BIKEL-PL/MPe_V6_open_source/README.md

# MPeV6 - DIY ebike computer

EN: More info https://bikel.pl/en/mpe-computer-for-e-bike/

PL: Więcej informacji: https://bikel.pl/komputer-mpe-do-e-bike/
