BIKEL-PL/MPe_V6_open_source/firmware/source/MPe-firmware/README.md

# MPe-firmware

Firmware of MPe main board - Atmega328P / Arduino
