BIKEL-PL/MPe_V6_open_source/docs/photos/20200317_091047.jpg

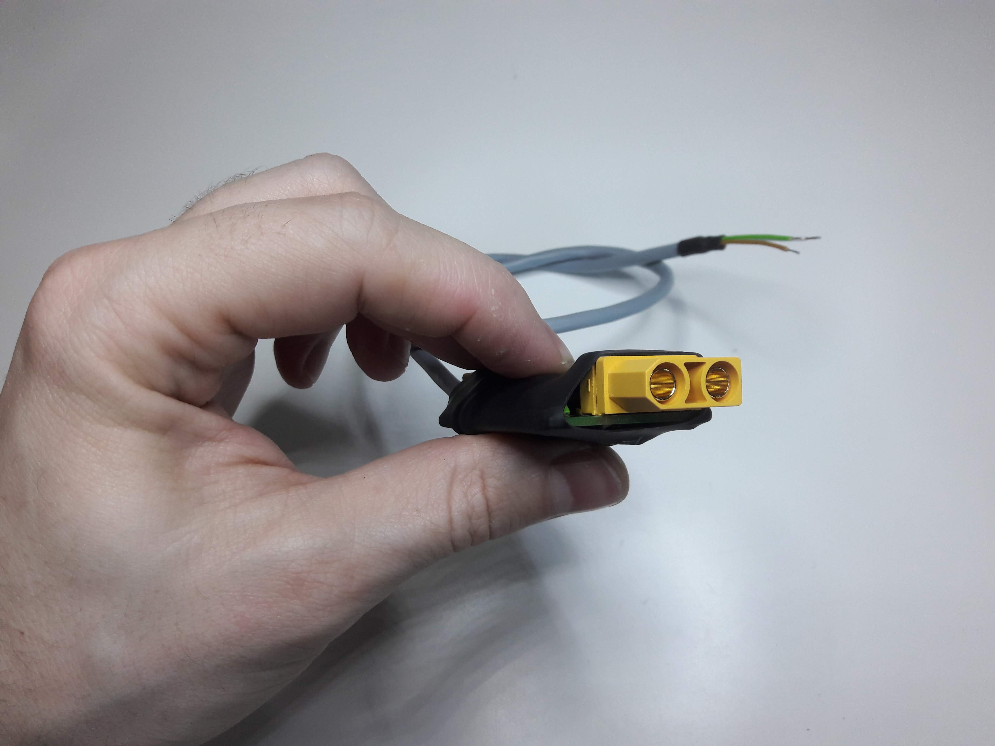
docs/photos/20200317_091047.jpg
