BIKEL-PL/MPe_V6_open_source/docs/photos/20200317_093044.jpg

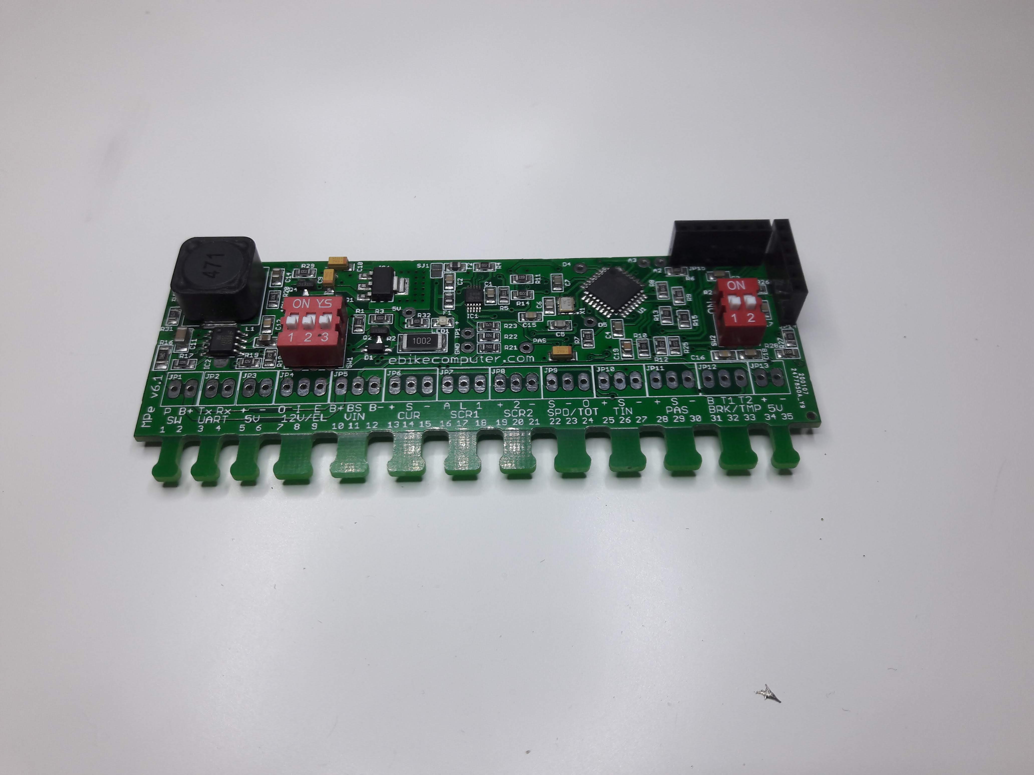
docs/photos/20200317_093044.jpg
