BIKEL-PL/MPe_V6_open_source/docs/photos/20211012_111339.jpg

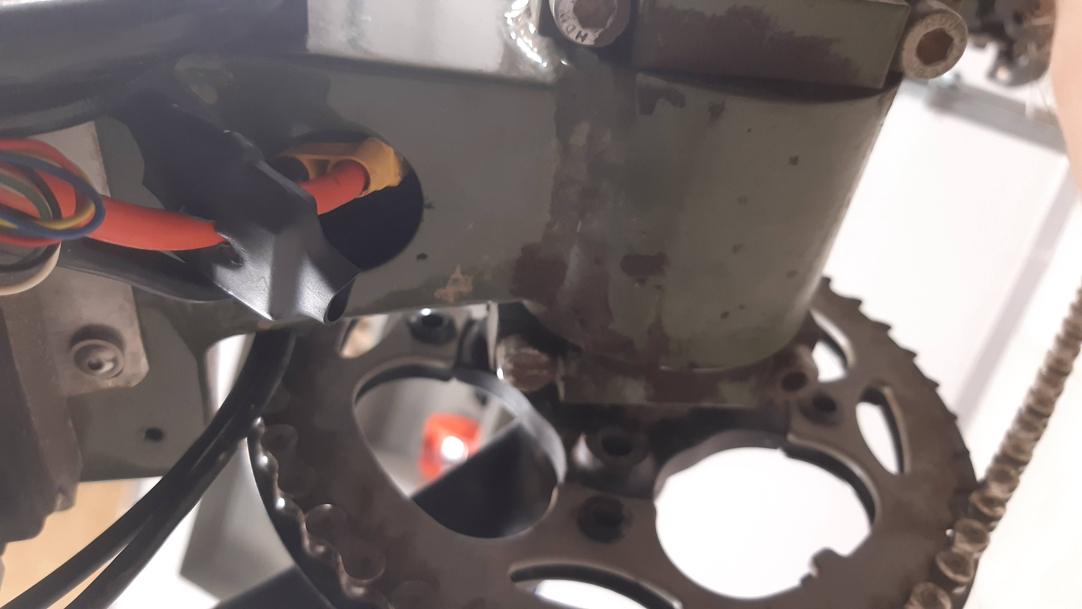
docs/photos/20211012_111339.jpg
