BIKEL-PL/MPe_V6_open_source/docs/photos/20211012_130520.jpg

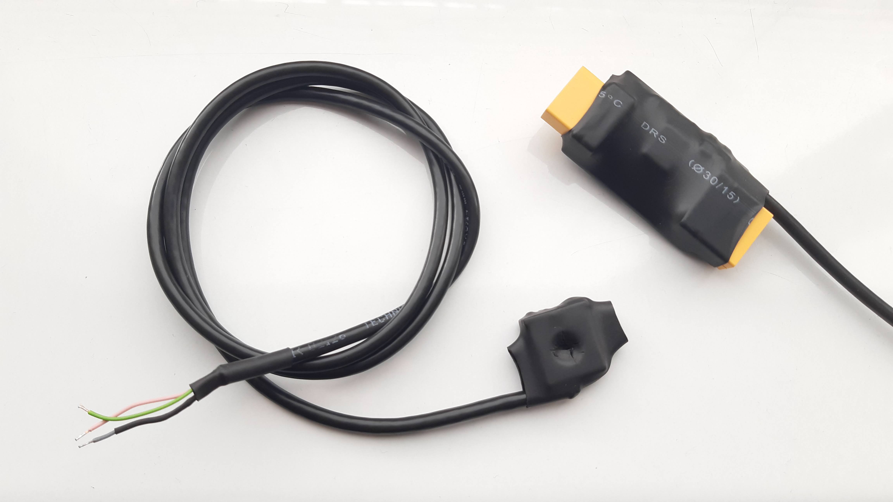
docs/photos/20211012_130520.jpg
