BIKEL-PL/MPe_V6_open_source/hardware/mainboard/gerber/BOM.xls

Comment | Designator | Footprint | JLCPCB Part #
2 | R20 | 0805 | C17606
2 | R32 | 0805 | C17606
1.5k | R19 | 0603 | C22843
100K | R10 | 0603 | C25803
100K | R15 | 0603 | C25803
100k | R16 | 0603 | C25803
100nF | C1 | 0603 | C14663
100nF | C17 | 0603 | C14663
100nF | C18 | 0603 | C14663
100nF | C2 | 0603 | C14663
100nF | C20 | 0603 | C14663
100nF | C3 | 0603 | C14663
100nF | C4 | 0603 | C14663
100nF | C7 | 0603 | C14663
10K | R12 | 0603 | C25804
10K | R13 | 0603 | C25804
10k | R25 | 0603 | C25804
10K | R29 | 0603 | C25804
10k | R4 | 0603 | C25804
10K | R44 | 0603 | C25804
10K | R45 | 0603 | C25804
10K | R46 | 0603 | C25804
10k | R5 | 0603 | C25804
10k | R6 | 0603 | C25804
10nF | C12 | 0805 | C1710
10nF | C15 | 0603 | C57112
10nF | C16 | 0603 | C57112
10uF | C10 | CASE-A_3216 | C7171
10uF | C8 | CASE-A_3216 | C7171
10uF | C9 | CASE-A_3216 | C7171
12pF | C5 | 0603 | C38523
12pF | C6 | 0603 | C38523
13k | R18 | 0603 | C22797
1k | R1 | 0603 | C21190
1k | R2 | 0603 | C21190
1k | R26 | 0603 | C21190
1k | R27 | 0603 | C21190
1k | R30 | 0603 | C21190
1k | R31 | 0603 | C21190
1k | R33 | 0603 | C21190
1k | R34 | 0603 | C21190
1k | R35 | 0603 | C21190
1k | R36 | 0603 | C21190
1k | R37 | 0603 | C21190
1k | R38 | 0603 | C21190
1k | R39 | 0603 | C21190
1k | R40 | 0603 | C21190
1k | R41 | 0603 | C21190
1k | R42 | 0603 | C21190
1k | R43 | 0603 | C21190
1k | R7 | 0603 | C21190
1nF | C19 | 0603 | C1588
1uF | C11 | 1206 | C13832
1uF | C13 | 0603 | C15849
200mA 60V | FU2 | 1812 | C70108
22k | R24 | 0603 | C31850
22uF | C14 | 0805 | C45783
2k2 | R11 | 0603 | C4190
2k2 | R14 | 0603 | C4190
2k2 | R28 | 0603 | C4190
2k2 | R8 | 0603 | C4190
2k2 | R9 | 0603 | C4190
470uH SLF12555T-102MR34-PF | L1 | SMD-PIND-12.5x12.5x8_2.9x5.4 | C169382
4k7 | R23 | 0805 | C17673
4k7 | R3 | 0603 | C23162
4u7 | C21 | 0603 | C19666
560k | R17 | 0603 | C23203
75k | R21 | 0805 | C17819
75k | R22 | 0805 | C17819
ADS1115 | IC1 | MSOP-10 | C37593
AMS1117-5.0 | IC3 | SOT-223 | C6187
ATMEGA328P_TQFP | U1 | TQFP-32_7x7x08P | C14877
Diode | D1 | SOD-123 | C64898
Diode | D5 | SOD-123 | C64898
ferrit805 | F1 | 0805 | C1017
green 5V | LED1 | 0805 | C2297
LM5017MR/NOPB | IC2 | SOIC-8_EP_150mil | C34355
red 12V | LED2 | 0805 | C84256
Schottky SS14 | D3 | DO-214AC | C2480
TVS 13Vrmw | TS2 | DO-214AA | C283991
TVS 90Vrmw | TS1 | DO-214AA | C173538
TVS 90Vrmw | TS3 | DO-214AA | C173538
X322516MLB4SI | X1 | SMD-3225_4P | C13738
Zener 5.6V | D2 | LL-34 | C8062
