BIKEL-PL/MPe_V6_open_source/hardware/current_sensor_boards/PowerPCB_180/gerber/BOM.xls

Comment | Designator | Footprint | LCSC Part #
1k | R1 | 0805 | C17513
100nF | C1 | 0805 | C49678
100nF | C2 | 0805 | C49678
