BIKEL-PL/MPe_V6_open_source/hardware/misc/APT_displays_flash_adapter/gerber/BOM_PRG_APT.xls

Comment | Designator | Footprint | LCSC Part #
22uH | L1 | SMD-PIND-12.5x12.5x6_2.9x5.4 | C169385
diode | D1 | SMA,DO-214AC | C8678
dc/dc | IC1 | SOT-23-6L | C84817
22uf | C1 | 0805 | C45783
22uf | C2 | 0805 | C45783
2k2 | R2 | 0805 | C17520
100k | R1 | 0805 | C17407
1000uF 6.3V | C3 | SMD-ECAP-8x10 | C134755
220uF 50V | C4 | SMD_10x10.5mm | C88818
USB MINI | CN1 | MINI_USB_SMD | C91144
10R0 | R4 | 1206 | C17903
