BIKEL-PL/MPe_V6_open_source/hardware/display_minioled/front/front.DXF

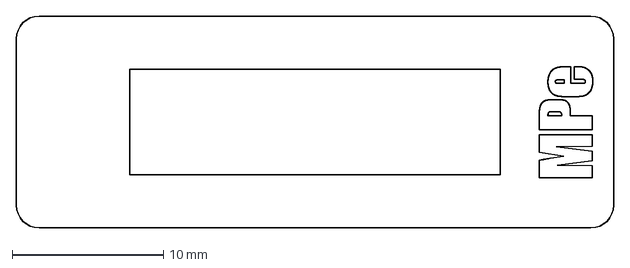
[picture p22: CAD file, 2025-05-25]
hardware/display_minioled/front/front.DXF
39.5 x 14.0 mm
