BIKEL-PL/MPe_V6_open_source/hardware/display_minioled/holder.STL

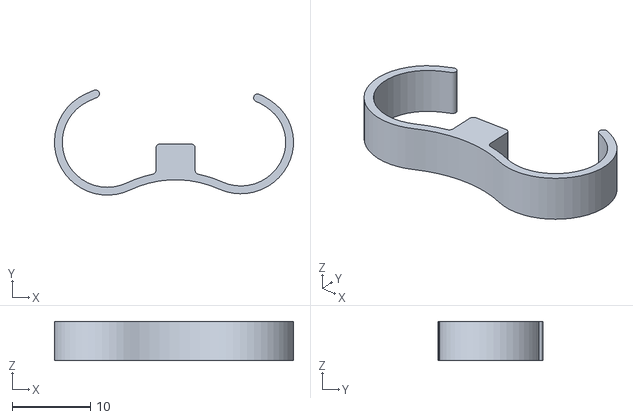
[picture p23: CAD file, 2025-05-25]
hardware/display_minioled/holder.STL
30.5 x 13.4 x 5.00
