BIKEL-PL/MPe_V6_open_source/hardware/mainboard_housing/bottom/MPeV6-bottom.STL

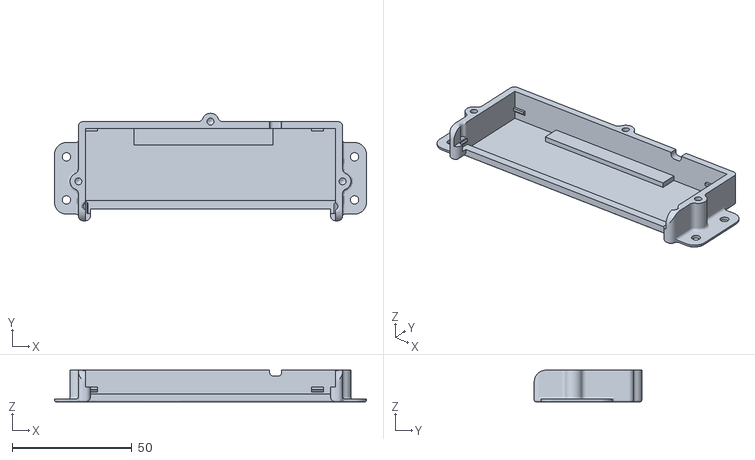
[picture p24: CAD file, 2025-05-25]
hardware/mainboard_housing/bottom/MPeV6-bottom.STL
130.5 x 45.0 x 13.3
