BIKEL-PL/MPe_V6_open_source/hardware/misc/bluetooth_adapter/stl/free-space-filler-small.STL

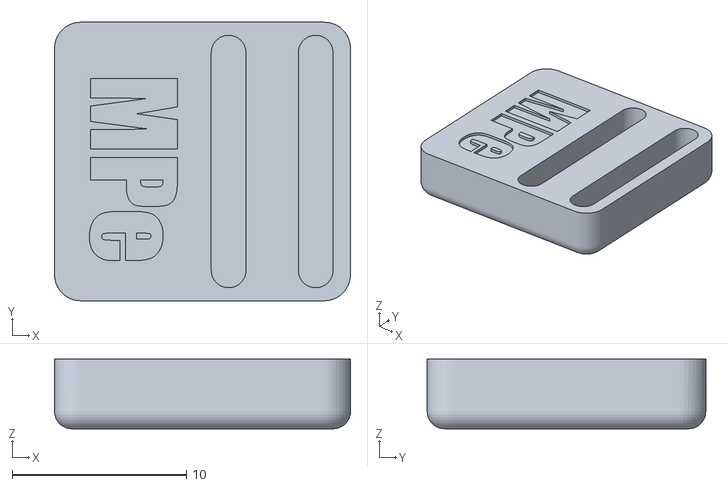
[picture p25: CAD file, 2025-05-25]
hardware/misc/bluetooth_adapter/stl/free-space-filler-small.STL
17.0 x 16.0 x 4.00
