BIKEL-PL/MPe_V6_open_source/hardware/display_minioled/MPe-minioled.STL

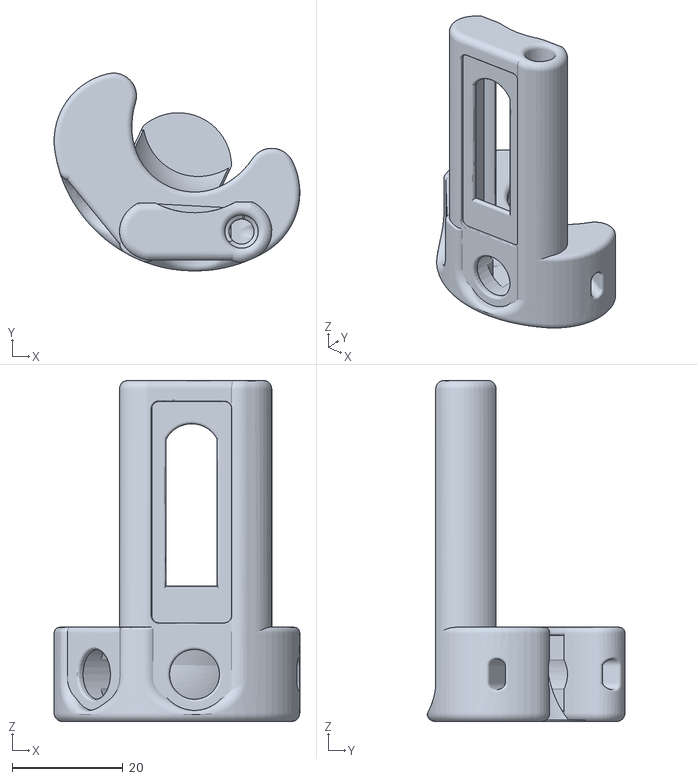
[picture p26: CAD file, 2025-05-25]
hardware/display_minioled/MPe-minioled.STL
44.3 x 35.7 x 61.5
