BIKEL-PL/MPe_V6_open_source/hardware/misc/bluetooth_adapter/stl/free-space-filler-large.STL

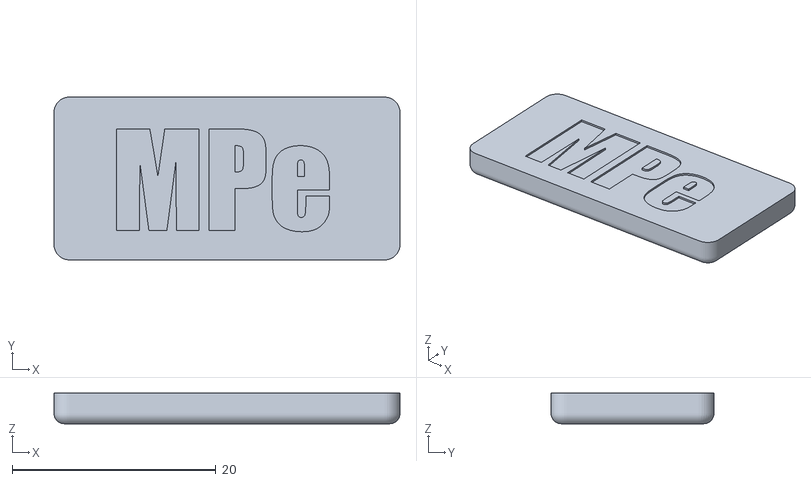
[picture p27: CAD file, 2025-05-25]
hardware/misc/bluetooth_adapter/stl/free-space-filler-large.STL
34.0 x 16.0 x 3.00
