BIKEL-PL/MPe_V6_open_source/hardware/display_minioled/assembly-video.txt

https://youtu.be/sY0HN42a0uE
https://youtu.be/gLpKM8VGKTg
