BIKEL-PL/MPe_V6_open_source/docs/schematics/S1.02_MPeV6.pdf

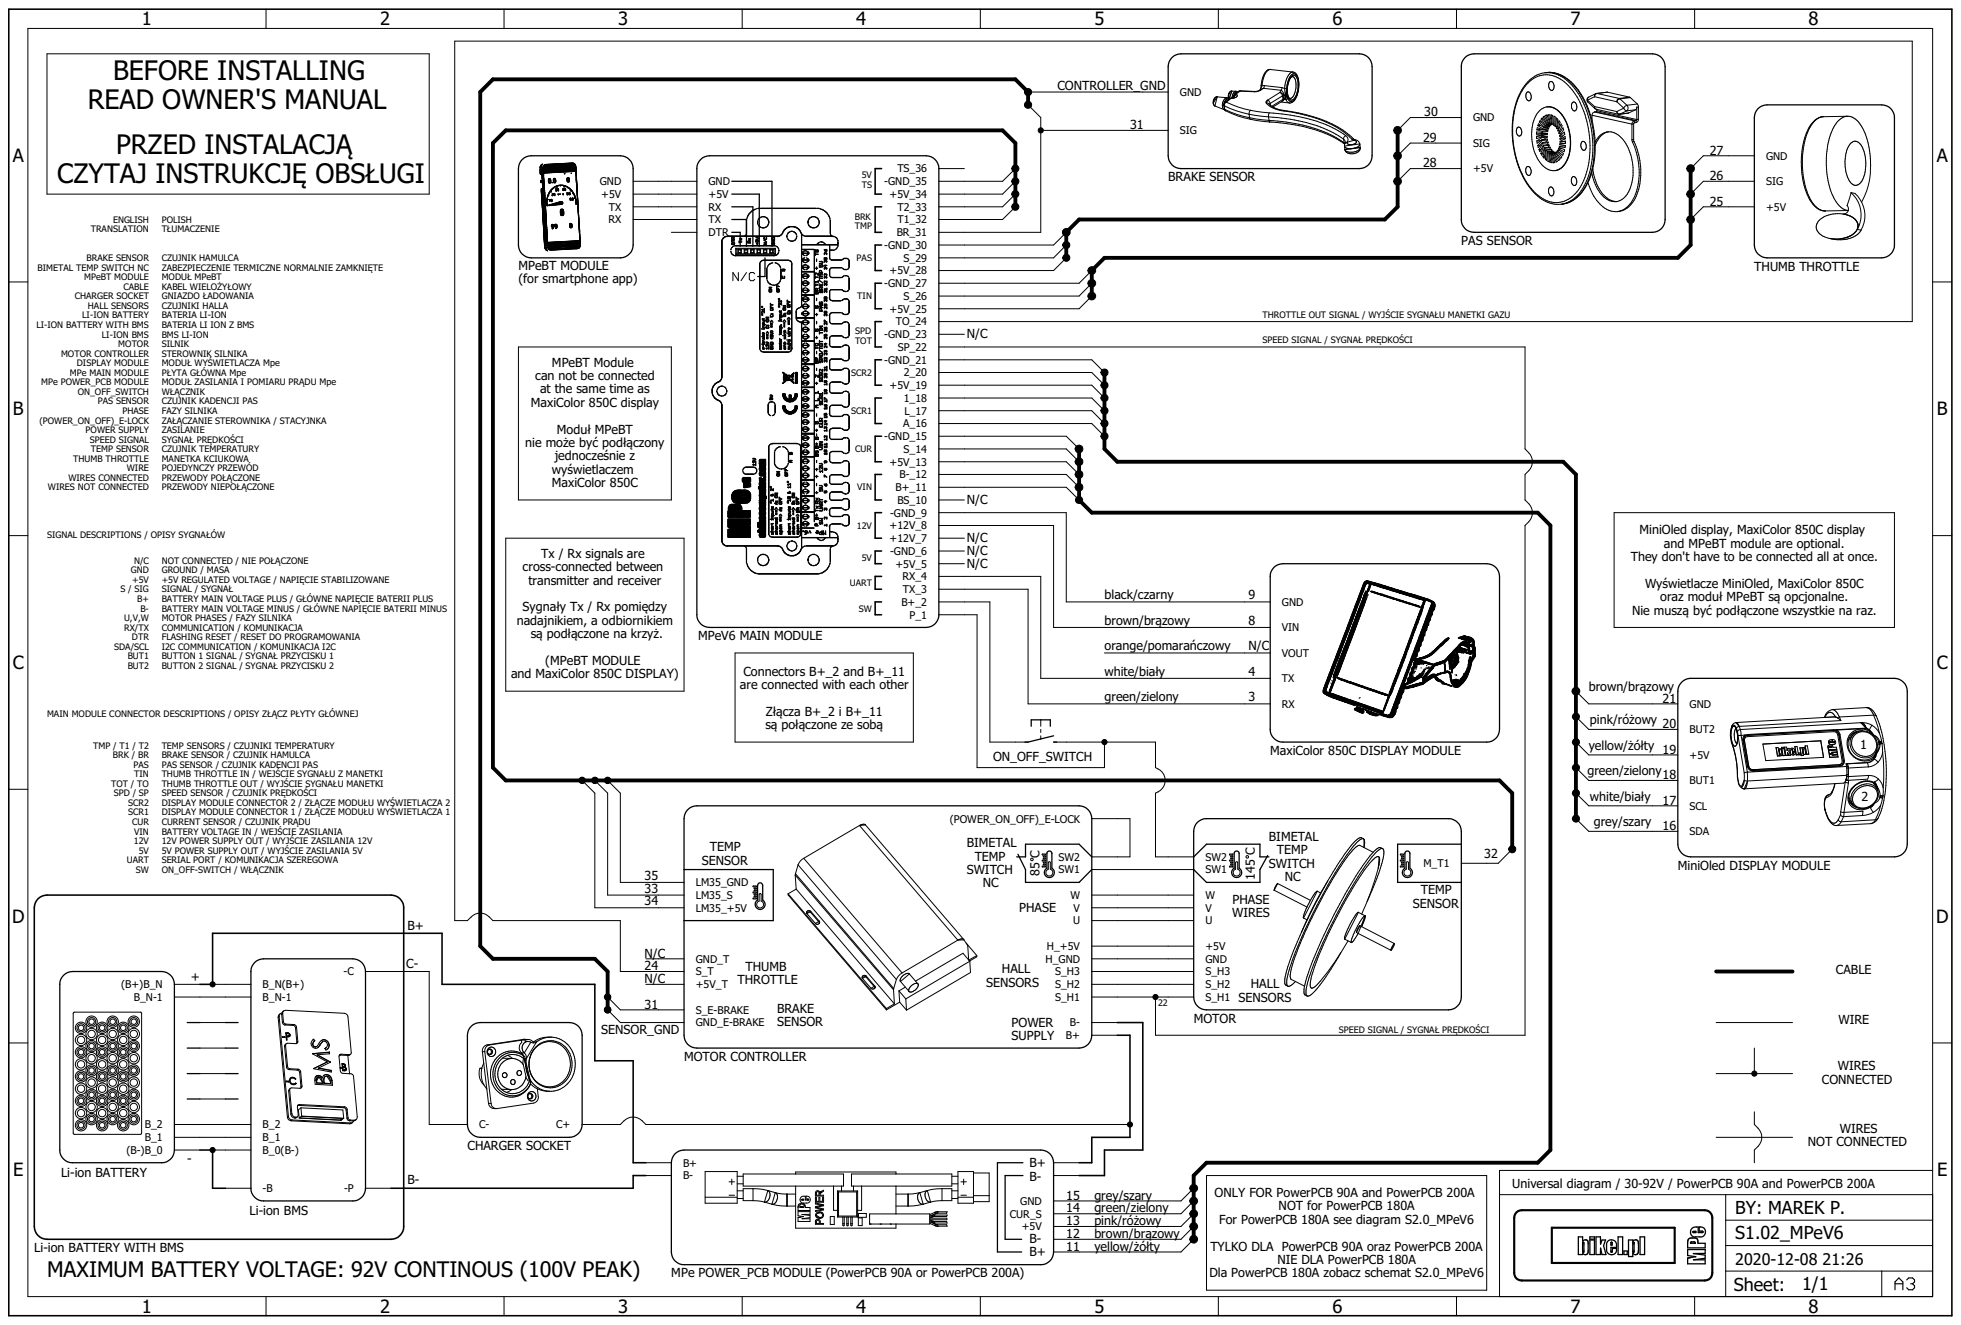
[picture p28: page 1]

BRAKE SENSOR MPeBT MODULE

BIMETAL TEMP SWITCH NC MPeBT MODULE CABLE CHARGER SOCKET HALL SENSORS

ZABEZPIECZENIE TERMICZNE NORMALNIE ZAMKNIĘTE MODUŁ MPeBT KABEL WIELOŻYŁOWY GNIAZDO ŁADOWANIA CZUJNIKI HALLA

(for smartphone app)

LI-ION BATTERY WITH BMS
LI-ION BMS MOTOR MOTOR CONTROLLER DISPLAY MODULE MPe MAIN MODULE MPe POWER_PCB MODULE ON_OFF_SWITCH

BATERIA LI-ION
BATERIA LI ION Z BMS BMS LI-ION

THROTTLE OUT SIGNAL / WYJŚCIE SYGNAŁU MANETKI GAZU

SILNIK
STEROWNIK SILNIKA MODUŁ WYŚWIETLACZA Mpe PŁYTA GŁÓWNA Mpe MODUŁ ZASILANIA I POMIARU PRĄDU Mpe WŁĄCZNIK CZUJNIK KADENCJI PAS

SPEED SIGNAL / SYGNAŁ PRĘDKOŚCI

MPeBT Module
can not be connected
at the same time as MaxiColor 850C display Moduł MPeBT

FAZY SILNIKA
ZAŁĄCZANIE STEROWNIKA / STACYJNKA
ZASILANIE
SYGNAŁ PRĘDKOŚCI CZUJNIK TEMPERATURY MANETKA KCIUKOWA

POWER SUPPLY
SPEED SIGNAL TEMP SENSOR

nie może być podłączony
jednocześnie z wyświetlaczem

THUMB THROTTLE WIRE WIRES CONNECTED WIRES NOT CONNECTED

SIGNAL DESCRIPTIONS / OPISY SYGNAŁÓW

MiniOled display, MaxiColor 850C display and MPeBT module are optional. They don't have to be connected all at once. Wyświetlacze MiniOled, MaxiColor 850C

Tx / Rx signals are
cross-connected between
transmitter and receiver Sygnały Tx / Rx pomiędzy nadajnikiem, a odbiornikiem

NOT CONNECTED / NIE POŁĄCZONE GROUND / MASA +5V REGULATED VOLTAGE / NAPIĘCIE STABILIZOWANE

SIGNAL / SYGNAŁ BATTERY MAIN VOLTAGE PLUS / GŁÓWNE NAPIĘCIE BATERII PLUS BATTERY MAIN VOLTAGE MINUS / GŁÓWNE NAPIĘCIE BATERII MINUS MOTOR PHASES / FAZY SILNIKA COMMUNICATION / KOMUNIKACJA

black/czarny brown/brązowy white/biały green/zielony orange/pomarańczowy

oraz moduł MPeBT są opcjonalne. Nie muszą być podłączone wszystkie na raz.

są podłączone na krzyż. (MPeBT MODULE

FLASHING RESET / RESET DO PROGRAMOWANIA
I2C COMMUNICATION / KOMUNIKACJA I2C
BUTTON 1 SIGNAL / SYGNAŁ PRZYCISKU 1 BUTTON 2 SIGNAL / SYGNAŁ PRZYCISKU 2

are connected with each other Złącza B+_2 i B+_11

brown/brązowy pink/różowy

MAIN MODULE CONNECTOR DESCRIPTIONS / OPISY ZŁĄCZ PŁYTY GŁÓWNEJ

są połączone ze sobą

TEMP SENSORS / CZUJNIKI TEMPERATURY BRAKE SENSOR / CZUJNIK HAMULCA

yellow/żółty green/zielony white/biały grey/szary

PAS SENSOR / CZUJNIK KADENCJI PAS THUMB THROTTLE IN / WEJŚCIE SYGNAŁU Z MANETKI THUMB THROTTLE OUT / WYJŚCIE SYGNAŁU MANETKI SPEED SENSOR / CZUJNIK PRĘDKOŚCI DISPLAY MODULE CONNECTOR 2 / ZŁĄCZE MODUŁU WYŚWIETLACZA 2 DISPLAY MODULE CONNECTOR 1 / ZŁĄCZE MODUŁU WYŚWIETLACZA 1 CURRENT SENSOR / CZUJNIK PRĄDU

BATTERY VOLTAGE IN / WEJŚCIE ZASILANIA
12V POWER SUPPLY OUT / WYJŚCIE ZASILANIA 12V
5V POWER SUPPLY OUT / WYJŚCIE ZASILANIA 5V
SERIAL PORT / KOMUNIKACJA SZEREGOWA ON_OFF-SWITCH / WŁĄCZNIK

CABLE WIRE WIRES CONNECTED WIRES NOT CONNECTED

Universal diagram / 30-92V / PowerPCB 90A and PowerPCB 200A

ONLY FOR PowerPCB 90A and PowerPCB 200A NOT for PowerPCB 180A

Li-ion BATTERY WITH BMS

MPe POWER_PCB MODULE (PowerPCB 90A or PowerPCB 200A)
