BIKEL-PL/MPe_V6_open_source/docs/schematics/S10.01_MPeV6.pdf

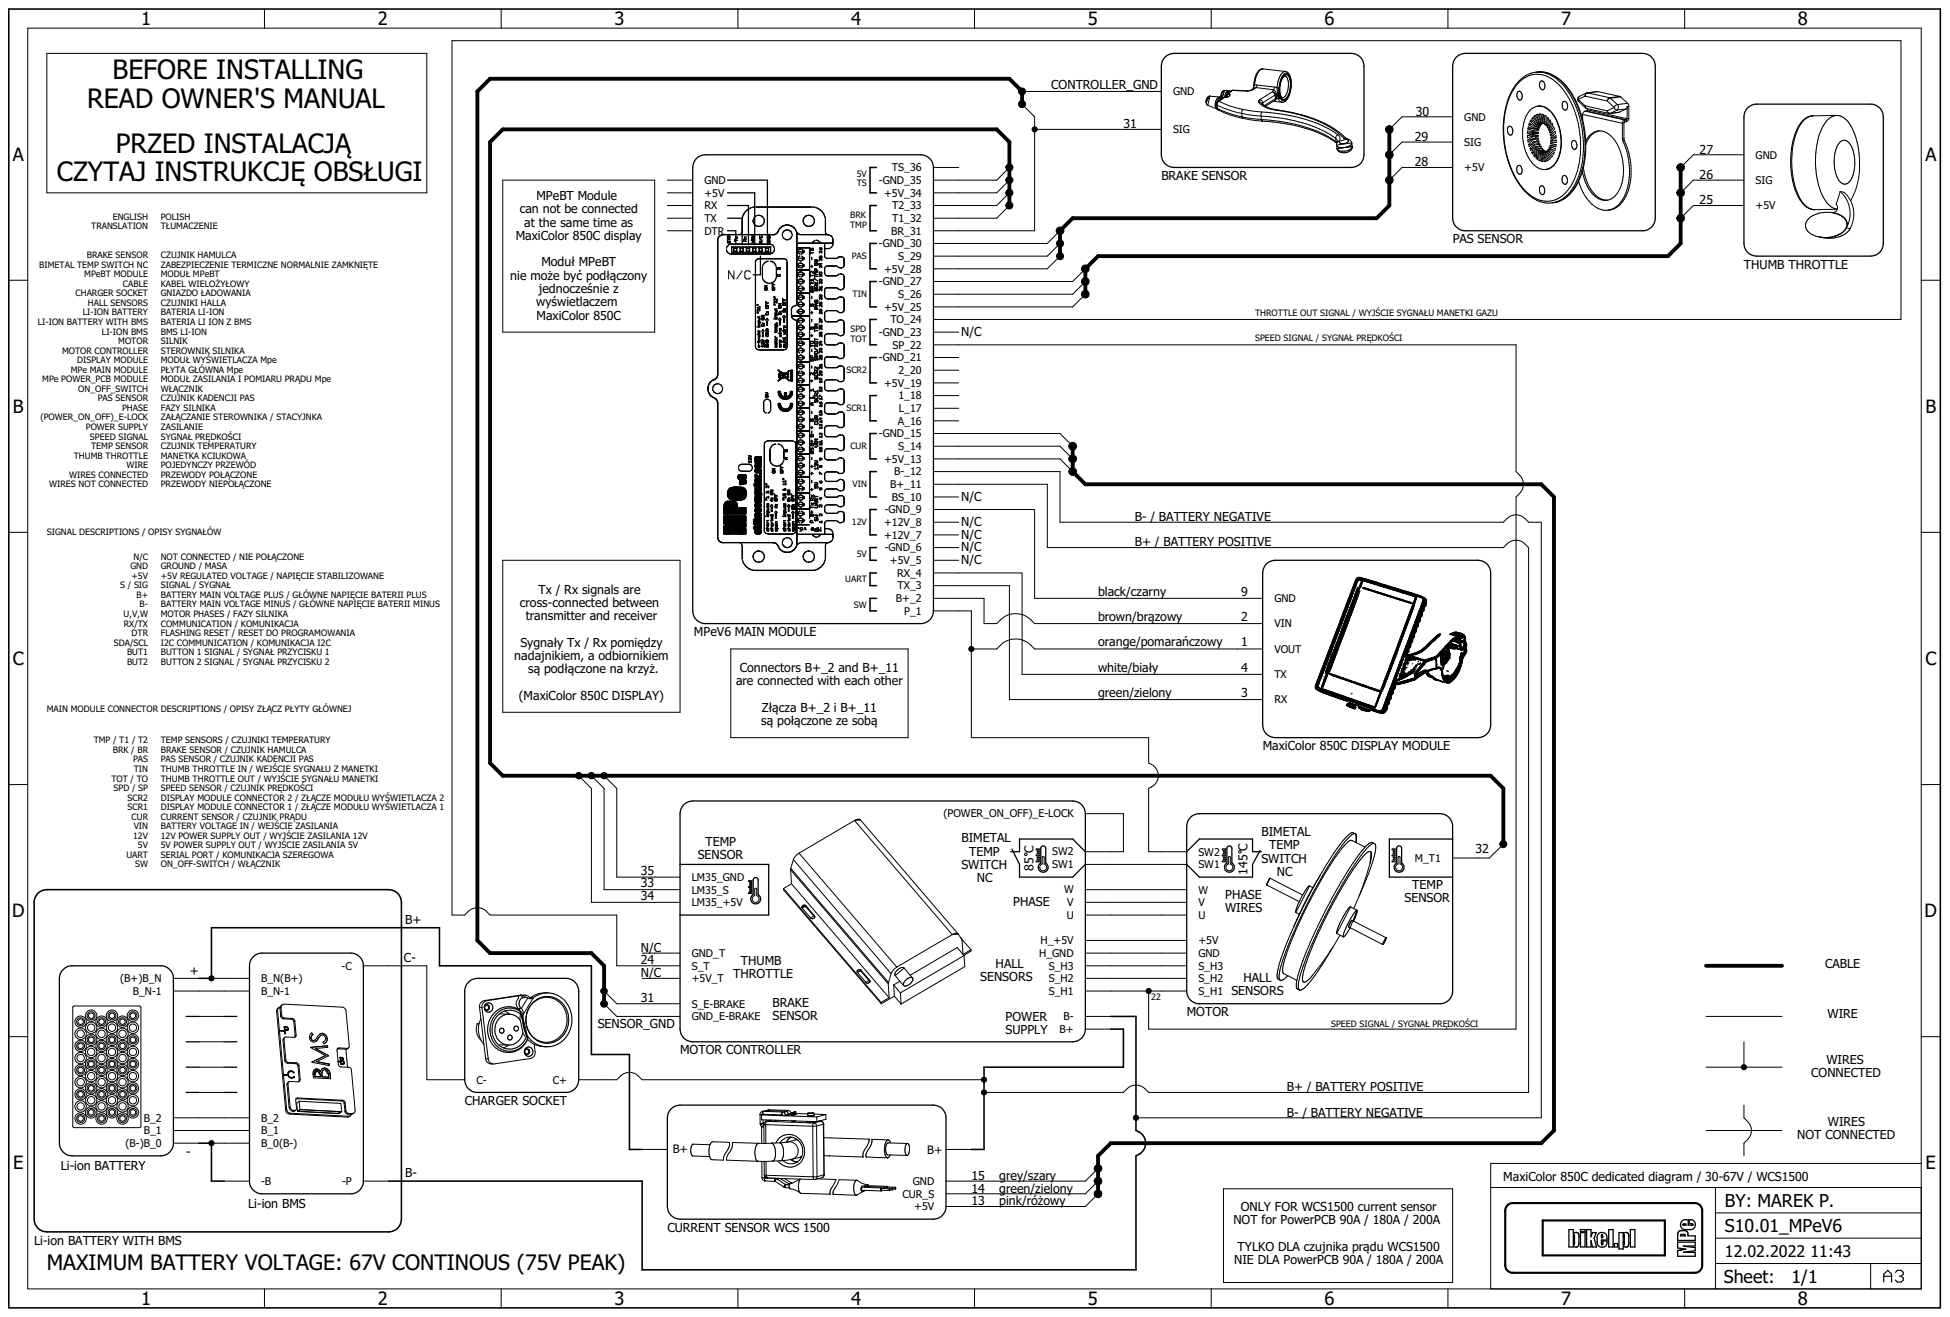
[picture p29: page 1]

MPeBT Module
can not be connected
at the same time as MaxiColor 850C display Moduł MPeBT

BIMETAL TEMP SWITCH NC MPeBT MODULE CABLE CHARGER SOCKET HALL SENSORS

ZABEZPIECZENIE TERMICZNE NORMALNIE ZAMKNIĘTE MODUŁ MPeBT KABEL WIELOŻYŁOWY GNIAZDO ŁADOWANIA CZUJNIKI HALLA

nie może być podłączony
jednocześnie z wyświetlaczem

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

BATERIA LI-ION
BATERIA LI ION Z BMS BMS LI-ION

THROTTLE OUT SIGNAL / WYJŚCIE SYGNAŁU MANETKI GAZU

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

SPEED SIGNAL / SYGNAŁ PRĘDKOŚCI

FAZY SILNIKA
ZAŁĄCZANIE STEROWNIKA / STACYJNKA
ZASILANIE
SYGNAŁ PRĘDKOŚCI CZUJNIK TEMPERATURY MANETKA KCIUKOWA

POWER SUPPLY
SPEED SIGNAL TEMP SENSOR

THUMB THROTTLE WIRE WIRES CONNECTED WIRES NOT CONNECTED

B- / BATTERY NEGATIVE B+ / BATTERY POSITIVE

SIGNAL DESCRIPTIONS / OPISY SYGNAŁÓW

NOT CONNECTED / NIE POŁĄCZONE GROUND / MASA +5V REGULATED VOLTAGE / NAPIĘCIE STABILIZOWANE

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

black/czarny brown/brązowy white/biały green/zielony orange/pomarańczowy

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

are connected with each other Złącza B+_2 i B+_11

MAIN MODULE CONNECTOR DESCRIPTIONS / OPISY ZŁĄCZ PŁYTY GŁÓWNEJ

są połączone ze sobą

TEMP SENSORS / CZUJNIKI TEMPERATURY BRAKE SENSOR / CZUJNIK HAMULCA

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

CABLE WIRE WIRES CONNECTED WIRES NOT CONNECTED

B+ / BATTERY POSITIVE B- / BATTERY NEGATIVE

MaxiColor 850C dedicated diagram / 30-67V / WCS1500 ONLY FOR WCS1500 current sensor NOT for PowerPCB 90A / 180A / 200A

Li-ion BATTERY WITH BMS
MAXIMUM BATTERY VOLTAGE: 67V CONTINOUS (75V PEAK)
