BIKEL-PL/MPe_V6_open_source/docs/schematics/S8.01_MPeV6.pdf

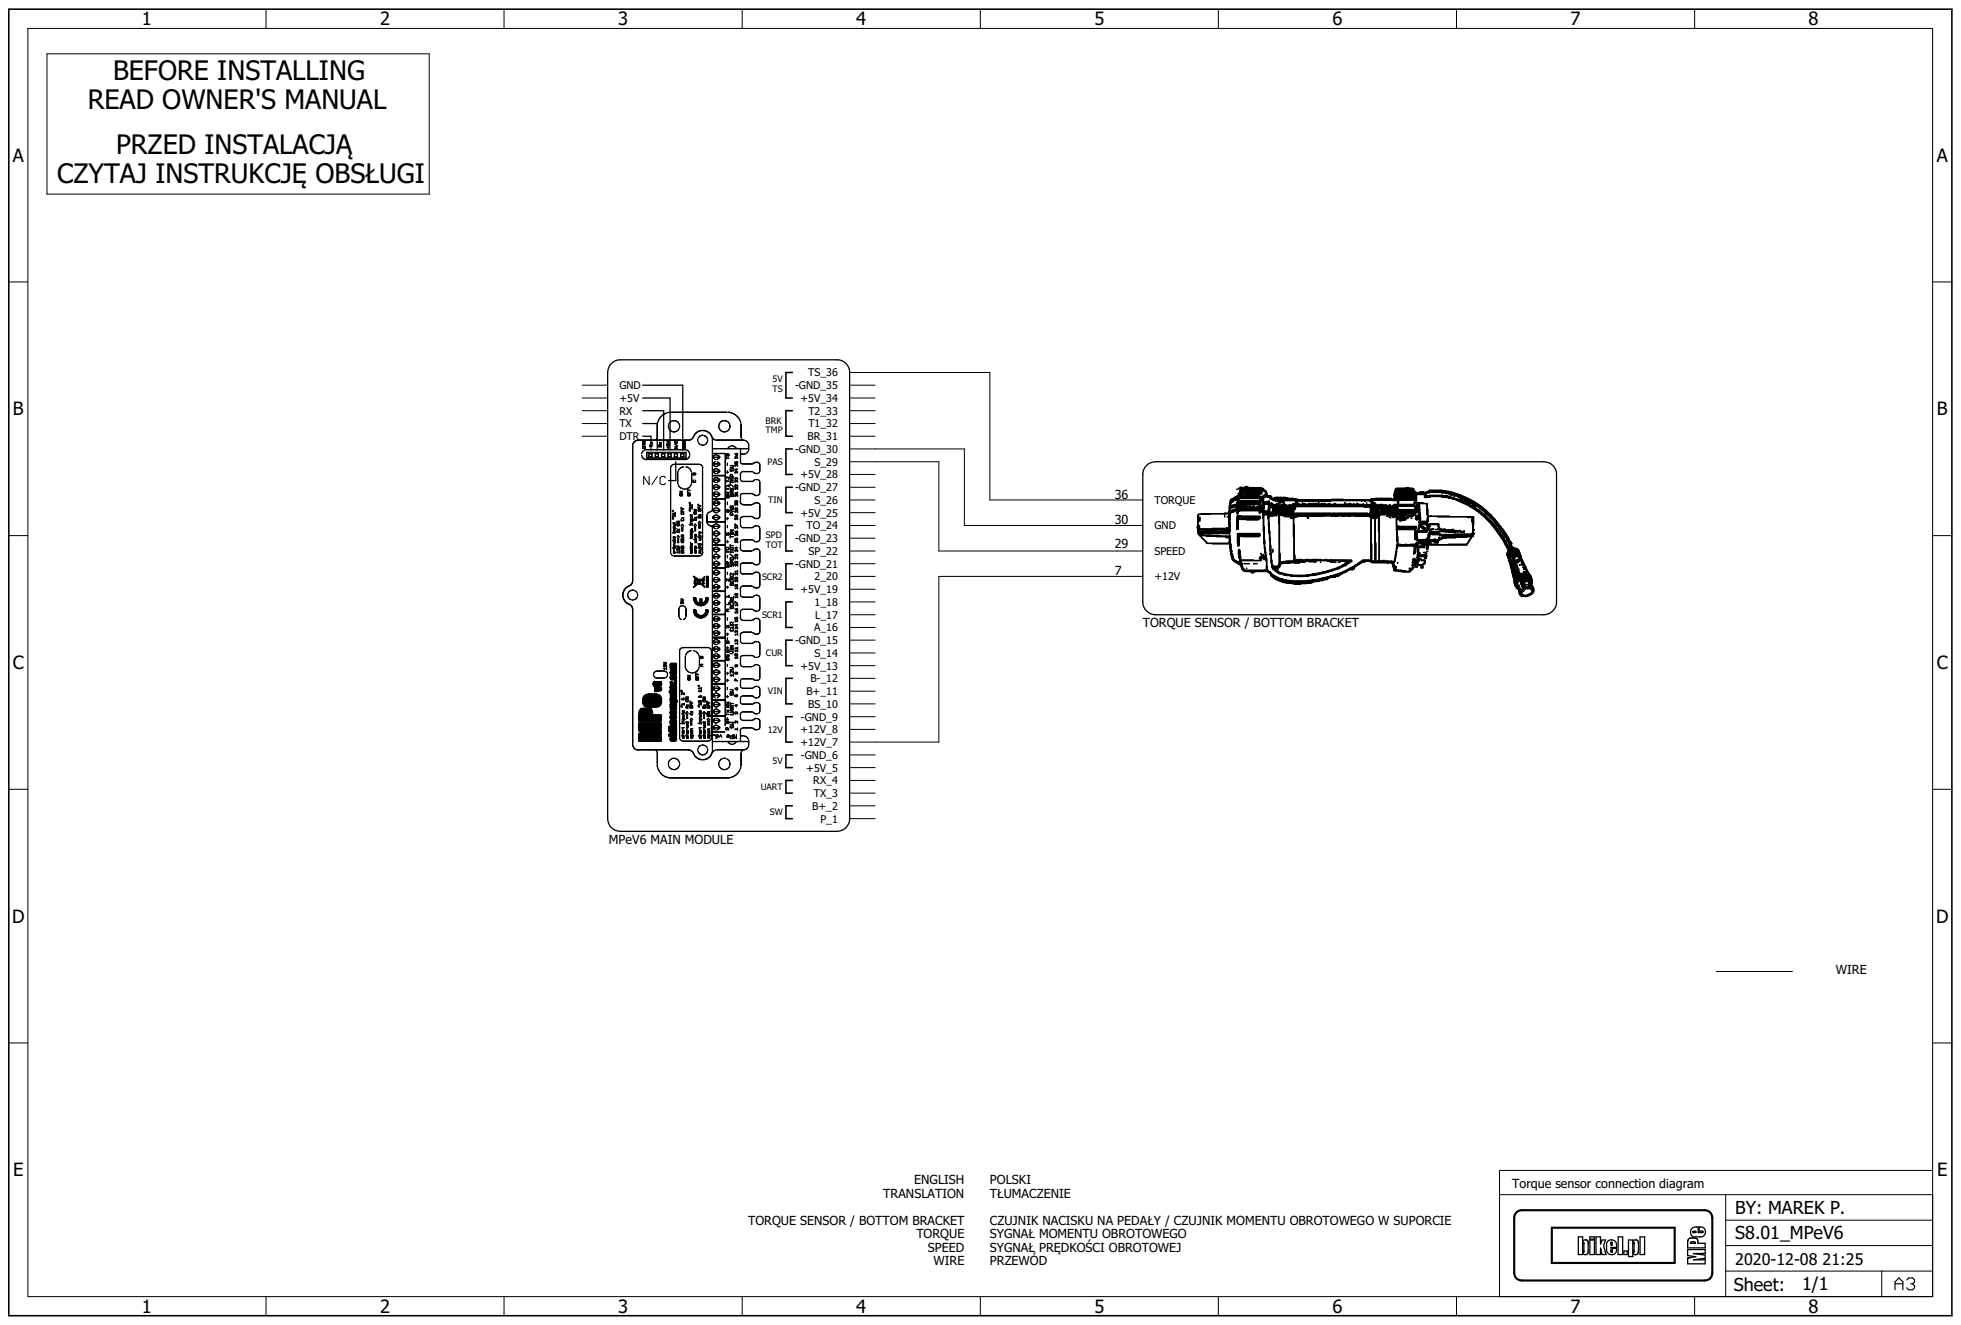
[picture p30: page 1]

TORQUE SENSOR / BOTTOM BRACKET

POLSKI TŁUMACZENIE CZUJNIK NACISKU NA PEDAŁY / CZUJNIK MOMENTU OBROTOWEGO W SUPORCIE

Torque sensor connection diagram

SYGNAŁ MOMENTU OBROTOWEGO
SYGNAŁ PRĘDKOŚCI OBROTOWEJ PRZEWÓD
