BIKEL-PL/MPe_V6_open_source/hardware/display_minioled/dimensions.PDF

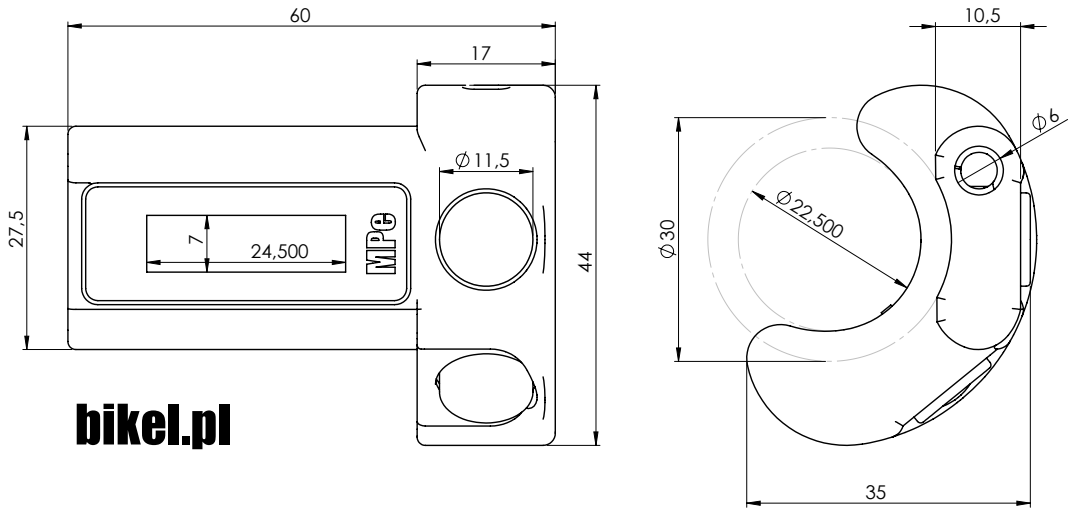
[picture p31: page 1]
