BIKEL-PL/MPe_V6_open_source/docs/schematics/S5.02_MPeV6.pdf

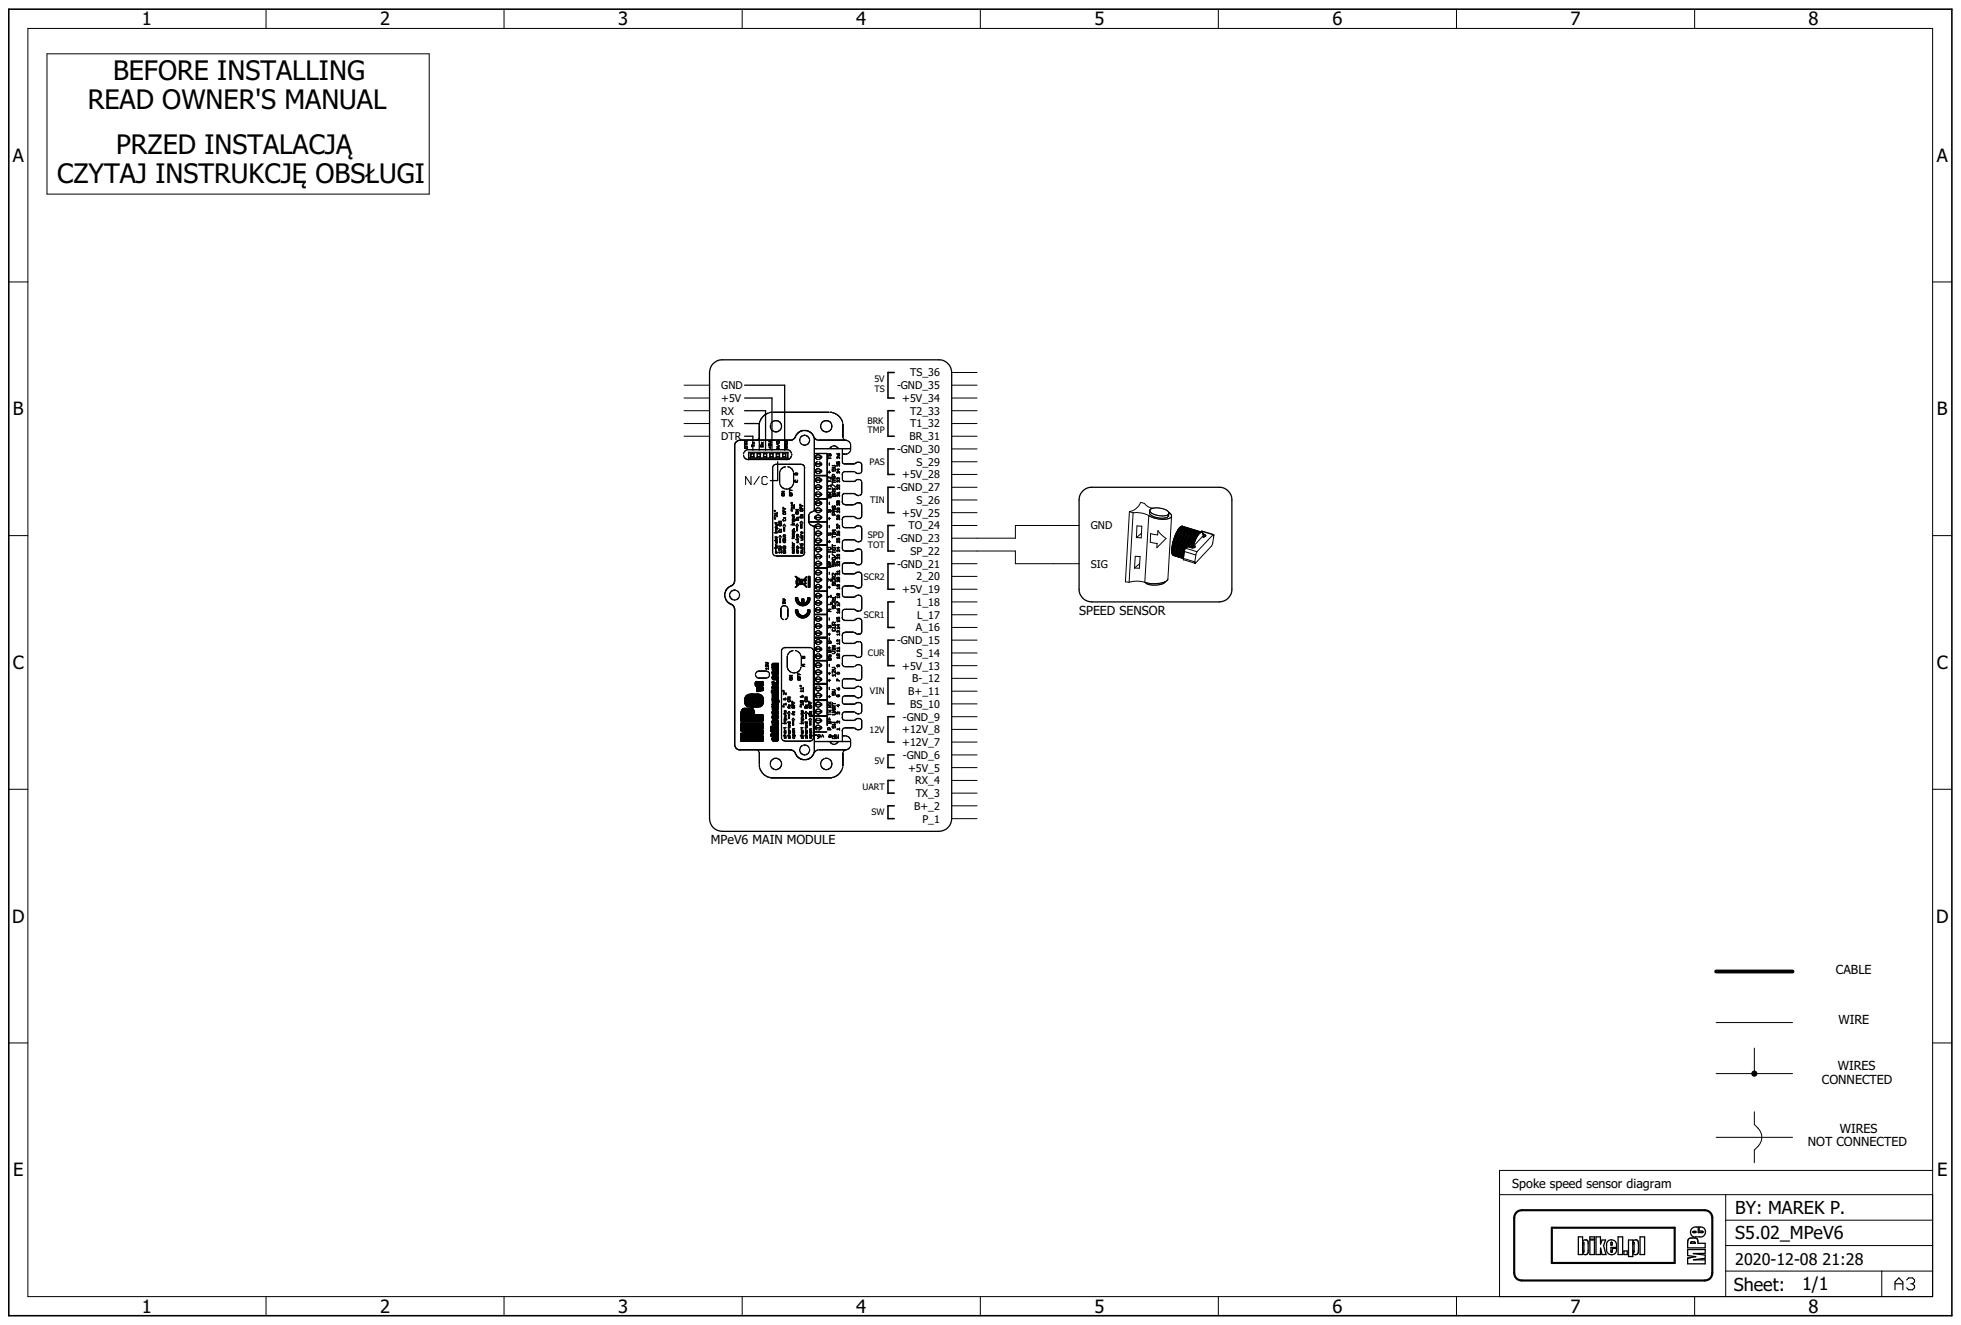
[picture p32: page 1]
