BIKEL-PL/MPe_V6_open_source/docs/schematics/S6.02_MPeV6.pdf

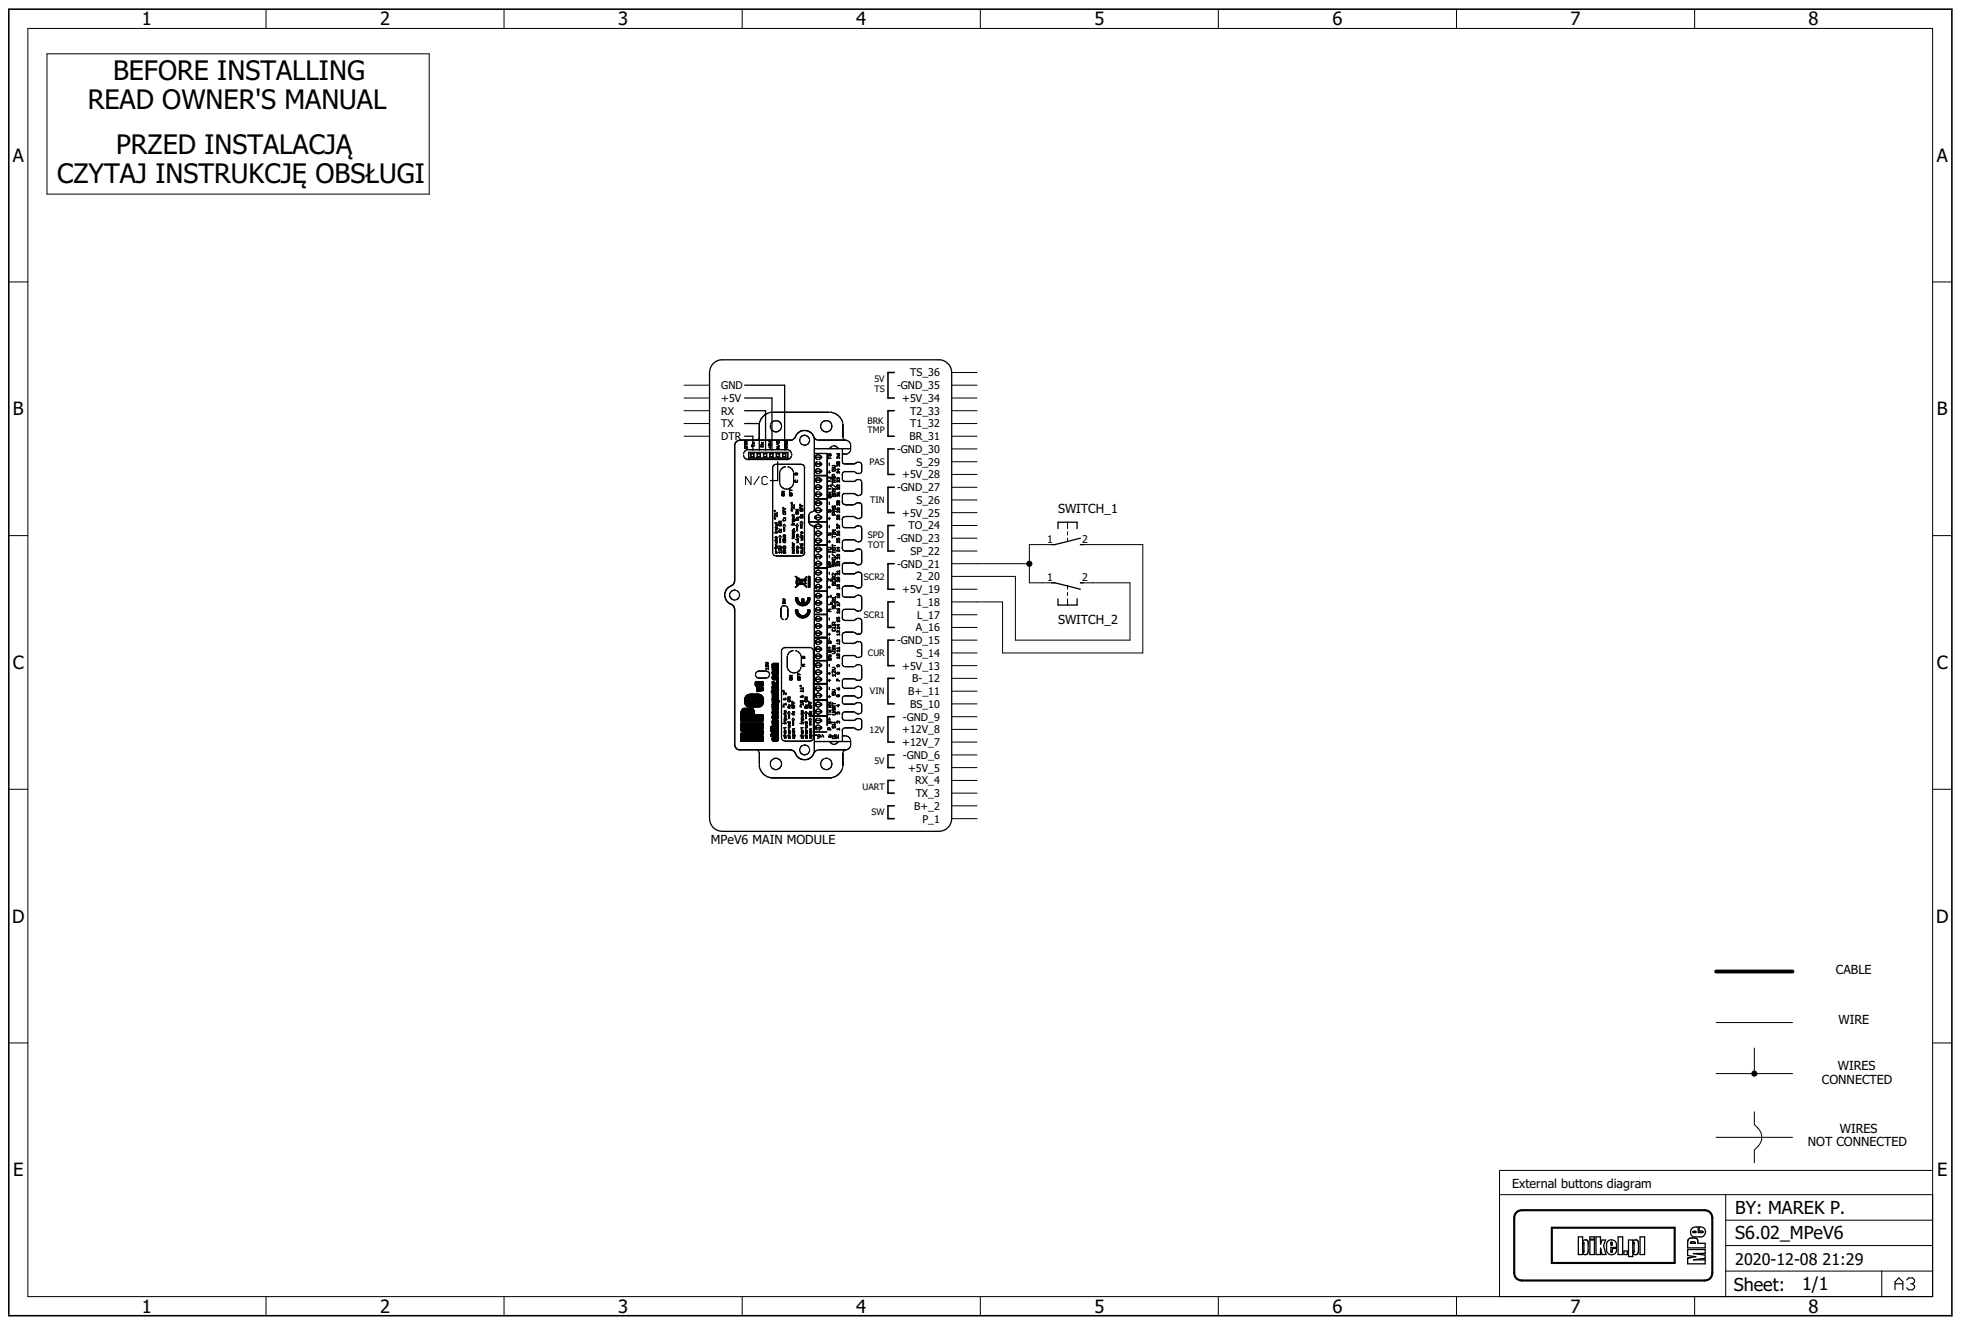
[picture p33: page 1]
