BIKEL-PL/MPe_V6_open_source/hardware/display_minioled/front/front-MPe.PDF

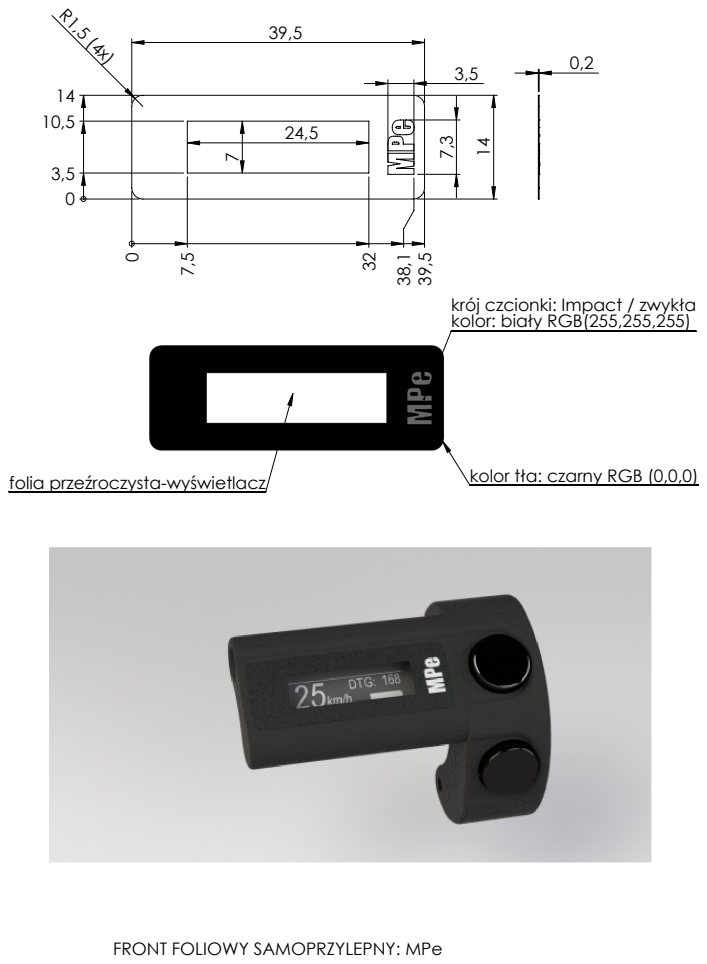
[picture p34: page 1]

krój czcionki: Impact / zwykła
kolor: biały RGB(255,255,255)

kolor tła: czarny RGB (0,0,0) folia przeźroczysta-wyświetlacz

FRONT FOLIOWY SAMOPRZYLEPNY: MPe
