BIKEL-PL/MPe_V6_open_source/hardware/mainboard/eagle/MPeV6.brd

## EAGLE design hardware/mainboard/eagle/MPeV6.brd (2025-05-25)

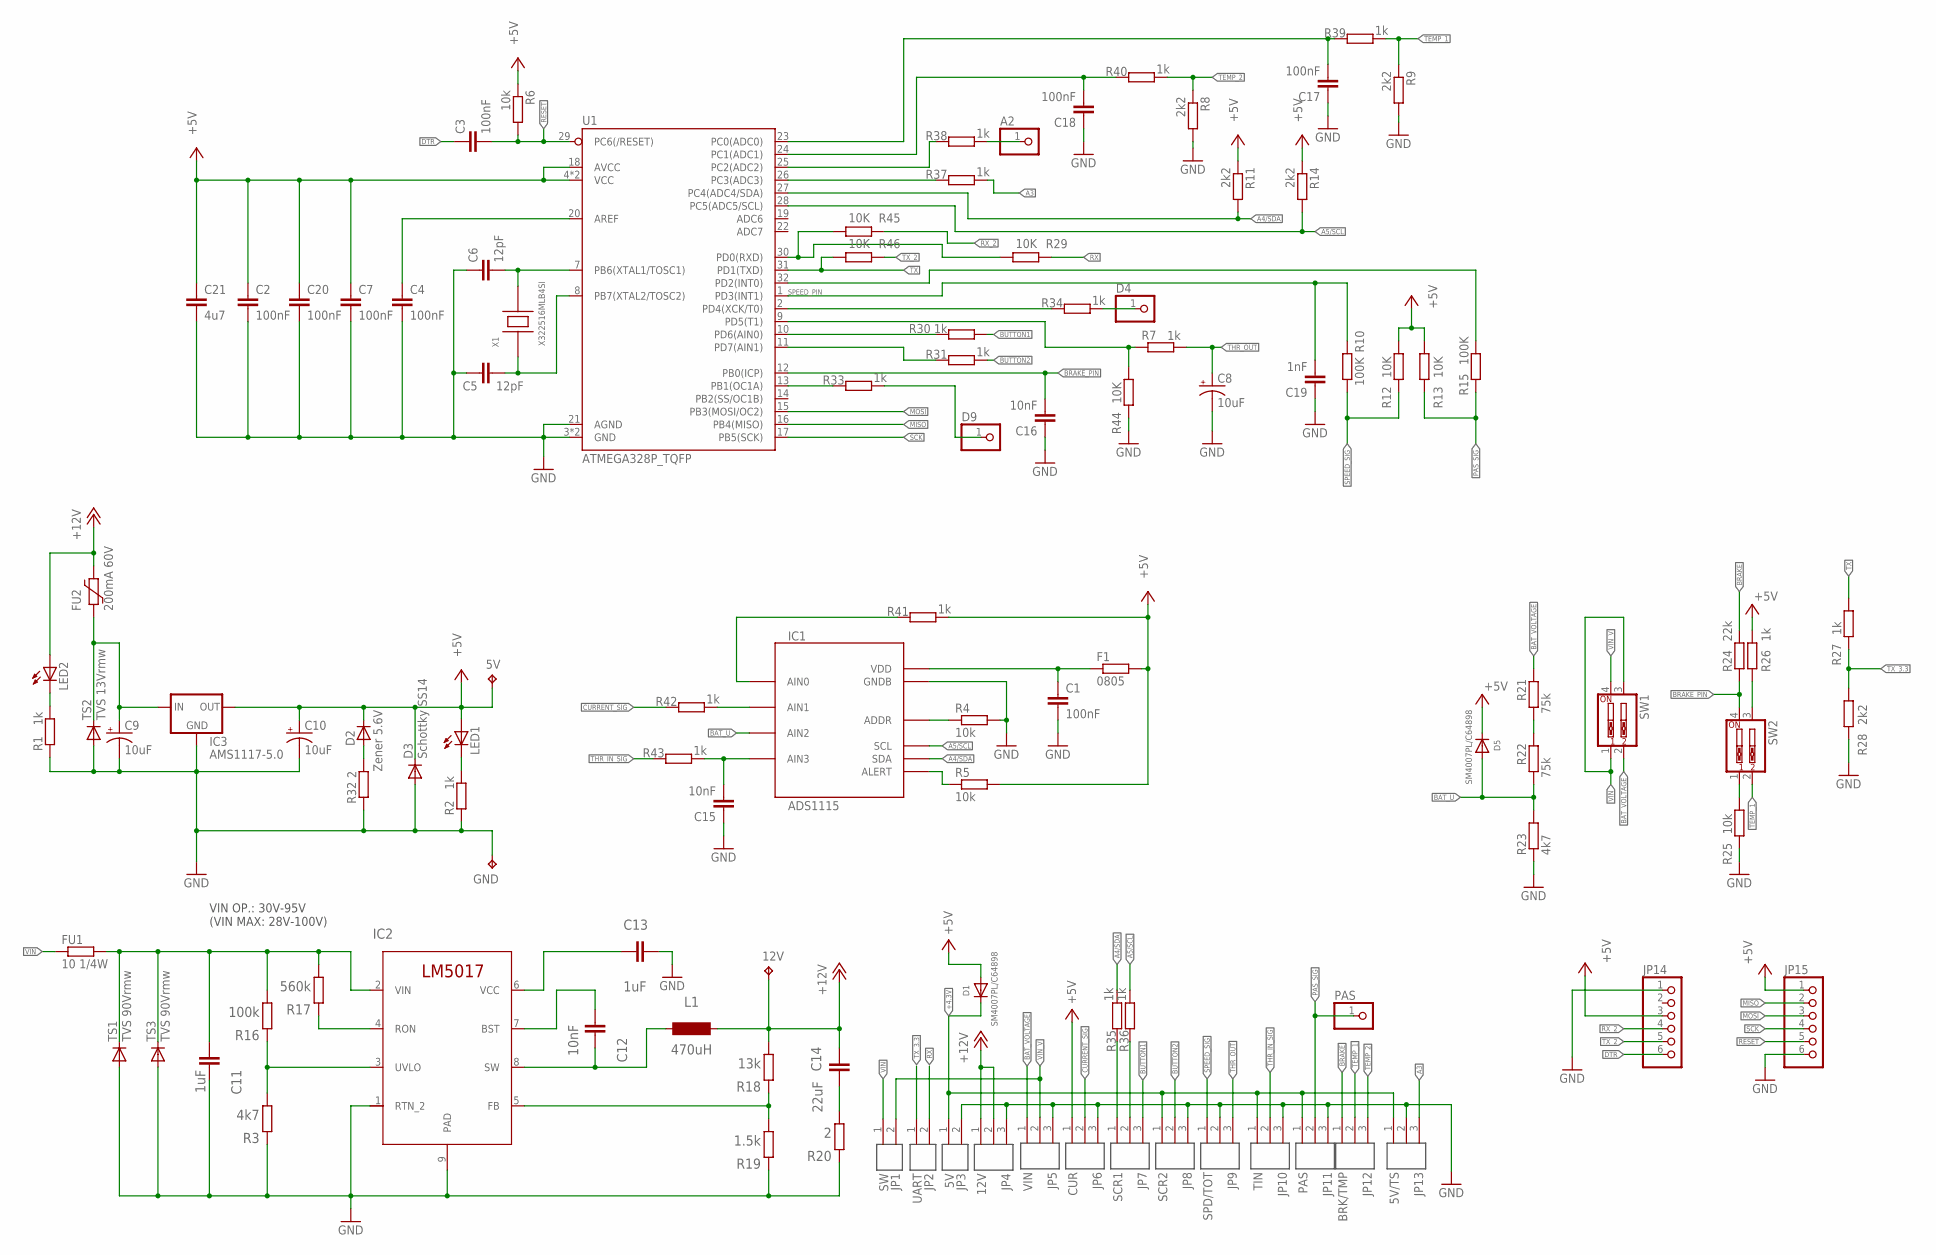
[picture p35: schematic MPeV6.sch]

Parts:
5V, 12V: TP_5V; P1-13
A2: PINHD-1X1; 1X01
C1, C2, C3, C4, C7, C17, C18, C20: 100nF; C0603
C5, C6: 12pF; C0603
C8, C9, C10: 10uF; EIA3216
C11: 1uF; C1206
C12: 10nF; C0805
C13: 1uF; C0603
C14: 22uF; C0805
C15, C16: 10nF; C0603
C19: 1nF; C0603
C21: 4u7; C0603
D1, D5: SM4007PL/C64898; SOD-123
D2: Zener 5.6V; MELF-MLL34
D3: Schottky SS14; DO-214AC
D4, D9: PINHD-1X1; 1X01
F1: 0805; R0805
FU1: 10 1/4W; 0204/7
FU2: 200mA 60V; 1812L
GND: TP_5V; P1-13
IC1: ADS1115; MSOP10_0.5
IC2: LM5017MR/NOPB; MRA08A
IC3: AMS1117-5.0; SOT223
JP1: SW; ARK254-PB+
JP2: UART; ARK254-2-COM
JP3: 5V; ARK254-2-5V
JP4: 12V; ARK254-3-12V-EL
JP5: VIN; ARK254-3-VIN
JP6: CUR; ARK254-3+S-
JP7: SCR1; ARK254-3
JP8: SCR2; ARK254-3
JP9: SPD/TOT; ARK254-3-SPD-TOT
JP10: TIN; ARK254-3+S-
JP11: PAS; ARK254-3+S-
JP12: BRK/TMP; ARK254-3-BRK-TMP
JP13: 5V/TS; ARK254-3-5V-TS
JP14, JP15: PINHD-1X6; 1X06
L1: 470uH; SLF12555T-102MR34-PF; LCSC C13738
LED1, LED2: LEDCHIP-LED0805; CHIP-LED0805
PAS: PINHD-1X1; 1X01
R1, R2, R7, R26, R27, R30, R31, R33, R34, R35, R36, R37, R38, R39, R40, R41, R42, R43: 1k; R0603
R3: 4k7; R0603
R4, R5, R6, R25: 10k; R0603
R8, R9, R11, R14, R28: 2k2; R0603
R10, R15: 100K; R0603
R12, R13, R29, R44, R45, R46: 10K; R0603
R16: 100k; R0603
R17: 560k; R0603
R18: 13k; R0603
R19: 1.5k; R0603
R20, R32: 2; R0805
R21, R22: 75k; R0805
R23: 4k7; R0805
R24: 22k; R0603
SW1, SW2: SW_DIP-2; EDG-02
TS1, TS3: TVS 90Vrmw; DO214AA
TS2: TVS 13Vrmw; DO214AA
U1: ATMEGA328P_TQFP; TQFP32-08
X1: X322516MLB4SI; IQG3225

Connections:
3: IC2.5 (FB), R18.2, R19.1
6: C13.2, IC2.6 (VCC)
7: IC2.4 (RON), R17.2
9: C14.2, R20.1
12V_FUSED: C9.+, FU2.2, IC3.3 (IN), TS2.C
+4.3V: D1.C, JP3.1, JP8.1, JP10.1, JP11.1, JP13.1
+5V: 5V.TP, C2.1, C7.1, C10.+, C20.1, C21.1, D1.A, D2.1 (C), D3.C, D5.C, F1.2, IC3.2 (OUT), IC3.4 (OUT), JP6.1, JP14.3, JP15.1, LED1.A, R5.2, R6.1, R11.1, R12.2, R13.2, R14.1, R26.2, R41.1, U1.4 (VCC), U1.6 (VCC), U1.18 (AVCC)
+12V: 12V.TP, C14.1, FU2.1, JP4.1, JP4.2, L1.P$2 (2), LED2.A, R18.1
A2: R38.2, U1.25 (PC2(ADC2))
A3: JP13.3, R37.1
A4/SDA: IC1.9 (SDA), R11.2, R35.1, U1.27 (PC4(ADC4/SDA))
A5/SCL: IC1.10 (SCL), R14.2, R36.1, U1.28 (PC5(ADC5/SCL))
BAT_U: D5.A, IC1.6 (AIN2), R22.1, R23.2
BAT_VOLTAGE: JP5.1, R21.2, SW1.2
BRAKE: JP12.1, R24.2
BRAKE_PIN: C16.2, R24.1, SW2.4, U1.12 (PB0(ICP))
BUTTON1: JP7.3, R30.1
BUTTON2: JP8.2, R31.1
CSIG: IC1.5 (AIN1), R42.1
CURRENT_SIG: JP6.2, R42.2
DTR: C3.1, JP14.6
GND: C1.2, C2.2, C4.2, C5.1, C6.1, C7.2, C8.-, C9.-, C10.-, C11.2, C13.1, C15.1, C16.1, C17.1, C18.1, C19.1, C20.2, C21.2, D3.A, GND.TP, IC1.3 (GNDB), IC2.1 (RTN_2), IC2.9 (PAD), IC3.1 (GND), JP3.2, JP4.3, JP5.3, JP6.3, JP8.3, JP9.2, JP10.3, JP11.3, JP13.2, JP14.1, JP15.6, R1.1, R2.1, R3.2, R4.2, R8.2, R9.2, R19.2, R20.2, R23.1, R25.1, R28.1, R32.1, R44.1, TS1.A, TS2.A, TS3.A, U1.3 (GND), U1.5 (GND), U1.21 (AGND)
MISO: JP15.2, U1.16 (PB4(MISO))
MOSI: JP15.3, U1.15 (PB3(MOSI/OC2))
unnamed: LED1.C, R2.2
unnamed: JP7.1, R35.2
unnamed: IC2.3 (UVLO), R3.1, R16.2
unnamed: JP7.2, R36.2
unnamed: D9.1, R33.1
unnamed: C12.1, IC2.7 (BST)
unnamed: R7.1, R44.2, U1.9 (PD5(T1))
unnamed: C4.1, U1.20 (AREF)
unnamed: LED2.C, R1.2
unnamed: R15.2, U1.32 (PD2(INT0))
unnamed: IC1.1 (ADDR), R4.1
unnamed: IC1.2 (ALERT), R5.1
unnamed: D4.1, R34.1
unnamed: IC1.4 (AIN0), R41.2
unnamed: R29.2, R45.2, U1.30 (PD0(RXD))
unnamed: D2.2 (A), R32.2
unnamed: R25.2, SW2.1
unnamed: R30.2, U1.10 (PD6(AIN0))
unnamed: R31.2, U1.11 (PD7(AIN1))
unnamed: R26.1, SW2.3
unnamed: C11.1, FU1.2, IC2.2 (VIN), R16.1, R17.1, TS1.C, TS3.C
unnamed: R33.2, U1.13 (PB1(OC1A))
unnamed: R34.2, U1.2 (PD4(XCK/T0))
unnamed: C6.2, U1.7 (PB6(XTAL1/TOSC1)), X1.3 (PIN2)
unnamed: C5.2, U1.8 (PB7(XTAL2/TOSC2)), X1.1 (PIN1)
unnamed: R21.1, R22.2
unnamed: R37.2, U1.26 (PC3(ADC3))
unnamed: A2.1, R38.1
PAS_SIG: JP11.2, PAS.1, R13.1, R15.1
RESET: C3.2, JP15.5, R6.2, U1.29 (PC6(/RESET))
RX: JP2.2, R29.1
RX_2: JP14.4, R45.1
SCK: JP15.4, U1.17 (PB5(SCK))
SPEED_PIN: C19.2, R10.2, U1.1 (PD3(INT1))
SPEED_SIG: JP9.1, R10.1, R12.1
SW: C12.2, IC2.8 (SW), L1.P$1 (1)
T1: C17.2, R39.2, U1.23 (PC0(ADC0))
T2: C18.2, R40.2, U1.24 (PC1(ADC1))
TEMP_1: JP12.2, R9.1, R39.1, SW2.2
TEMP_2: JP12.3, R8.1, R40.1
THR_IN_SIG: JP10.2, R43.2
THR_OUT: C8.+, JP9.3, R7.2
TSIG: C15.2, IC1.7 (AIN3), R43.1
TX: R27.2, R46.2, U1.31 (PD1(TXD))
TX_2: JP14.5, R46.1
TX_3.3: JP2.1, R27.1, R28.2
VDD: C1.1, F1.1, IC1.8 (VDD)
VIN: FU1.1, JP1.1, SW1.1, SW1.3
VIN_V: JP1.2, JP5.2, SW1.4

Notes on the sheet:
VIN OP.: 30V-95V (VIN MAX: 28V-100V)

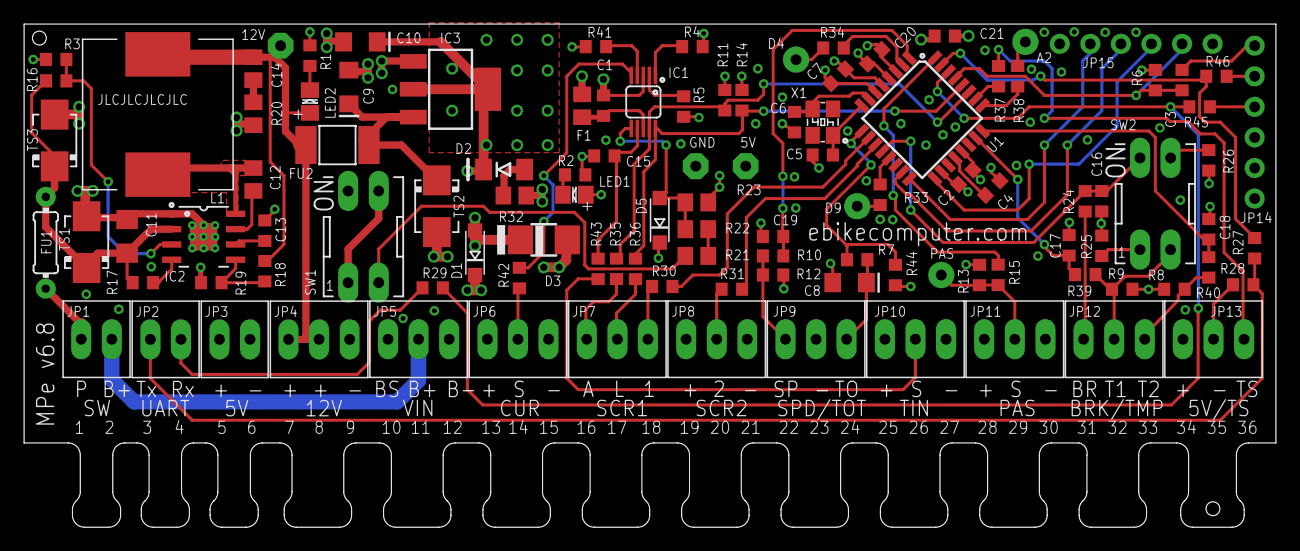
[picture p36: board MPeV6.brd from above]

Board: 4 copper layers, 104.0 x 41.8 mm, 109 parts (0 on the bottom side), 73 nets.
