BIKEL-PL/MPe_V6_open_source/hardware/current_sensor_boards/PowerPCB_180/eagle/PowerPCB_180.brd

## EAGLE design hardware/current_sensor_boards/PowerPCB_180/eagle/PowerPCB_180.brd (2025-05-25)

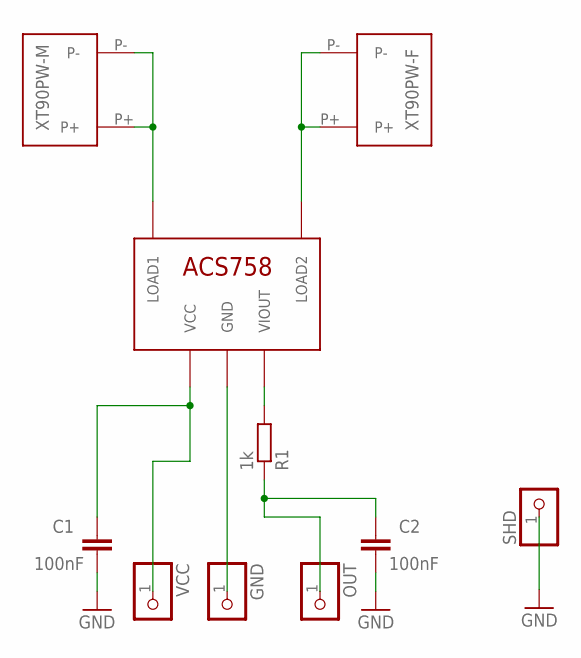
[picture p37: schematic PowerPCB_180.sch]

Parts:
ACS758_1: ACS758; ACS758-PFF
C1, C2: 100nF; C0805
GND: PINHD-1X1; 1X01
OUT: PINHD-1X1; 1X01
R1: 1k; R0805
SHD: PINHD-1X1; 1X01
VCC: PINHD-1X1; 1X01
XT90PW-F1: XT90PW-F
XT90PW-M1: XT90PW-M

Connections:
GND: ACS758_1.GND, C1.2, C2.2, GND.1, SHD.1
unnamed: ACS758_1.VIOUT, R1.2
unnamed: C2.1, OUT.1, R1.1
unnamed: ACS758_1.LOAD1, XT90PW-M1.P+, XT90PW-M1.P-
unnamed: ACS758_1.LOAD2, XT90PW-F1.P+, XT90PW-F1.P-
unnamed: ACS758_1.VCC, C1.1, VCC.1

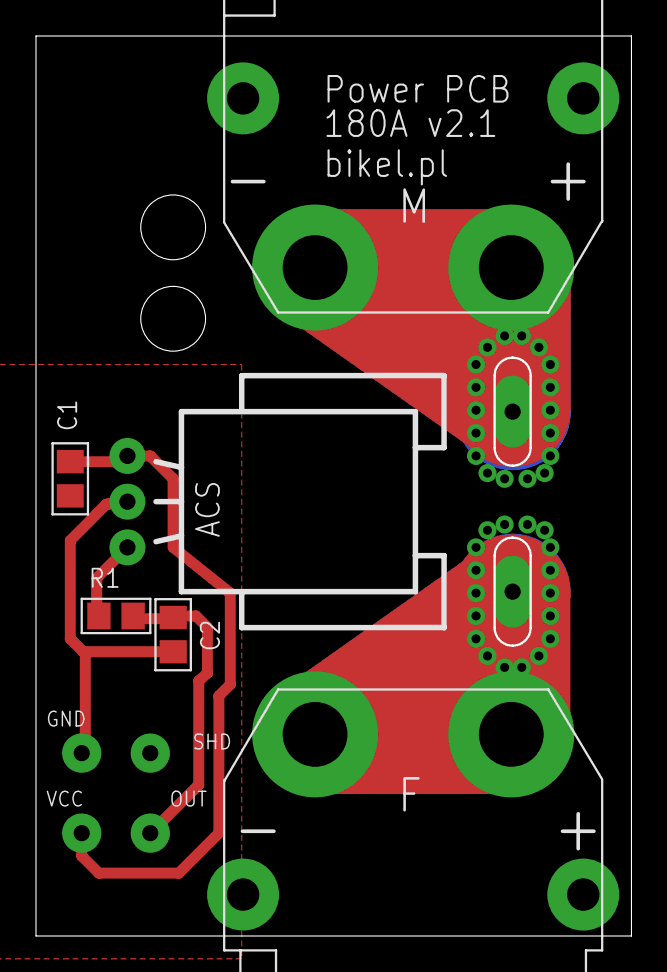
[picture p38: board PowerPCB_180.brd from above]

Board: 2 copper layers, 33.1 x 50.0 mm, 10 parts (0 on the bottom side), 6 nets.
