BIKEL-PL/MPe_V6_open_source/hardware/current_sensor_boards/PowerPCB_200/eagle/Power PCB 200.brd

## EAGLE design hardware/current_sensor_boards/PowerPCB_200/eagle/Power PCB 200.brd (2025-05-25)

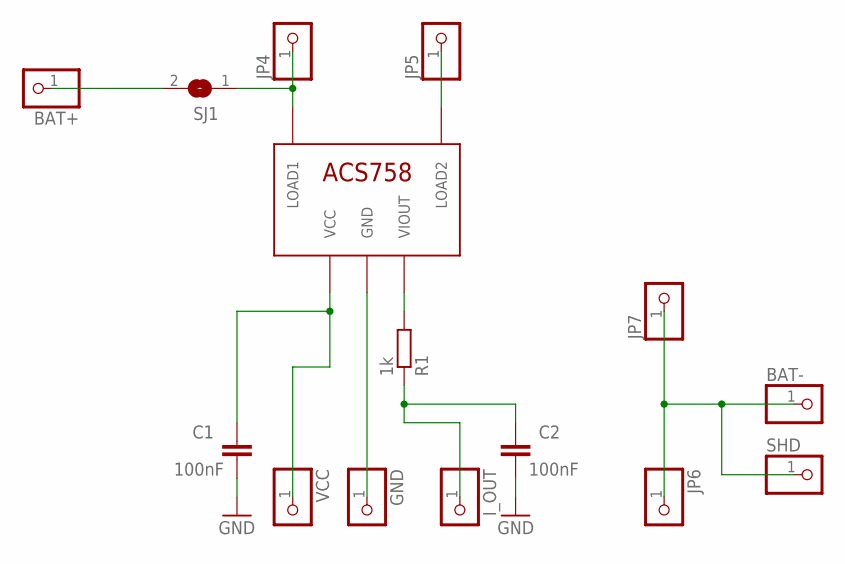
[picture p39: schematic Power PCB 200.sch]

Parts:
ACS758_1: ACS758; ACS758-PFF
BAT+: PINHD-1X1; 1X01
BAT-: PINHD-1X1; 1X01
C1, C2: 100nF; C0805
GND: PINHD-1X1; 1X01
I_OUT: PINHD-1X1; 1X01
JP4, JP5, JP6, JP7: PINHD-1X1; 1X01
R1: 1k; R0805
SHD: PINHD-1X1; 1X01
SJ1: SJ
VCC: PINHD-1X1; 1X01

Connections:
BAT-: BAT-.1, JP6.1, JP7.1, SHD.1
GND: ACS758_1.GND, C1.2, C2.2, GND.1
unnamed: ACS758_1.VIOUT, R1.2
unnamed: C2.1, I_OUT.1, R1.1
unnamed: ACS758_1.LOAD1, JP4.1, SJ1.1
unnamed: ACS758_1.LOAD2, JP5.1
unnamed: BAT+.1, SJ1.2
unnamed: ACS758_1.VCC, C1.1, VCC.1

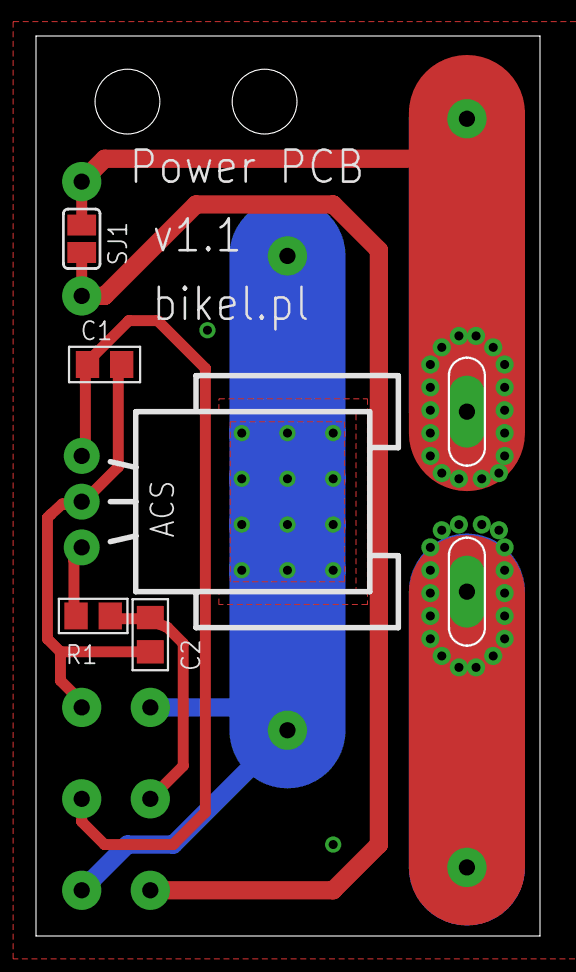
[picture p40: board Power PCB 200.brd from above]

Board: 2 copper layers, 28.0 x 50.0 mm, 15 parts (0 on the bottom side), 8 nets.
