BIKEL-PL/MPe_V6_open_source/hardware/misc/APT_displays_flash_adapter/PRG_APT.brd

## EAGLE design hardware/misc/APT_displays_flash_adapter/PRG_APT.brd (2025-05-25)

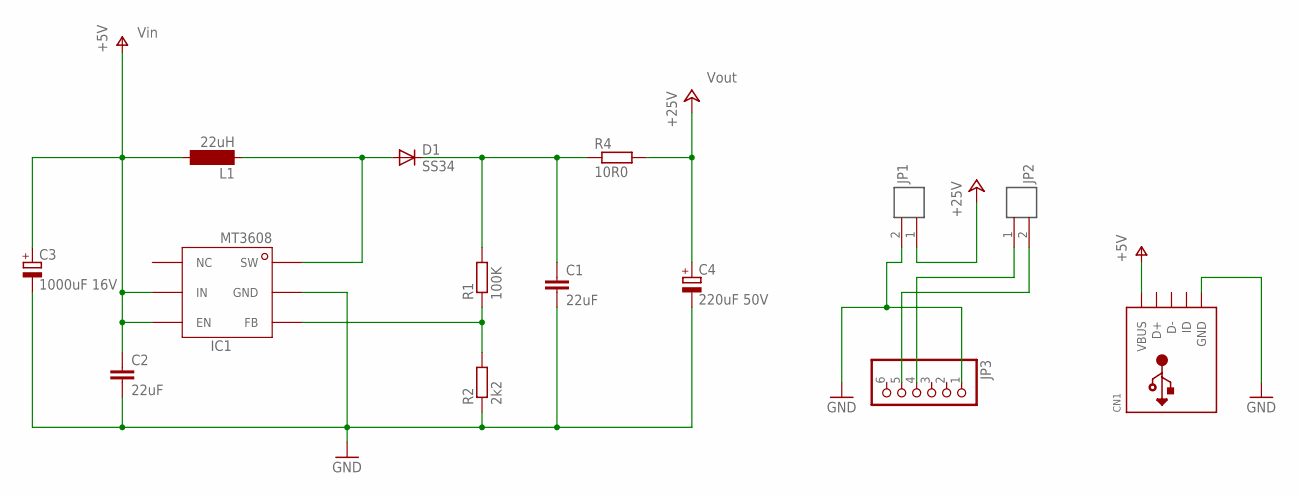
[picture p41: schematic PRG_APT.sch]

Parts:
C1, C2: 22uF; C0805
C3: 1000uF 16V; 153CLV-0810
C4: 220uF 50V; 153CLV-1010
CN1: USBMINIB; USB-MINIB
D1: SS34; DO-214AC
IC1: MT3608SOT23-6; SOT23-6
JP1, JP2: ARK254-2
JP3: PINHD-1X6; 1X06
L1: 22uH; SLF12555T-102MR34-PF
R1: 100K; R0805
R2: 2k2; R0805
R4: 10R0; M1206

Connections:
+25V: C4.+, JP1.1, R4.2
GND: C1.2, C2.2, C3.-, C4.-, CN1.GND, IC1.P$2 (GND), JP1.2, JP3.1, R2.1
unnamed: D1.A, IC1.P$1 (SW), L1.P$1 (1)
unnamed: IC1.P$3 (FB), R1.1, R2.2
unnamed: JP2.1, JP3.4
unnamed: JP2.2, JP3.5
unnamed: C1.1, D1.C, R1.2, R4.1
V+: C2.1, C3.+, CN1.VBUS, IC1.P$4 (EN), IC1.P$5 (IN), L1.P$2 (2)

Notes on the sheet:
Vin
Vout

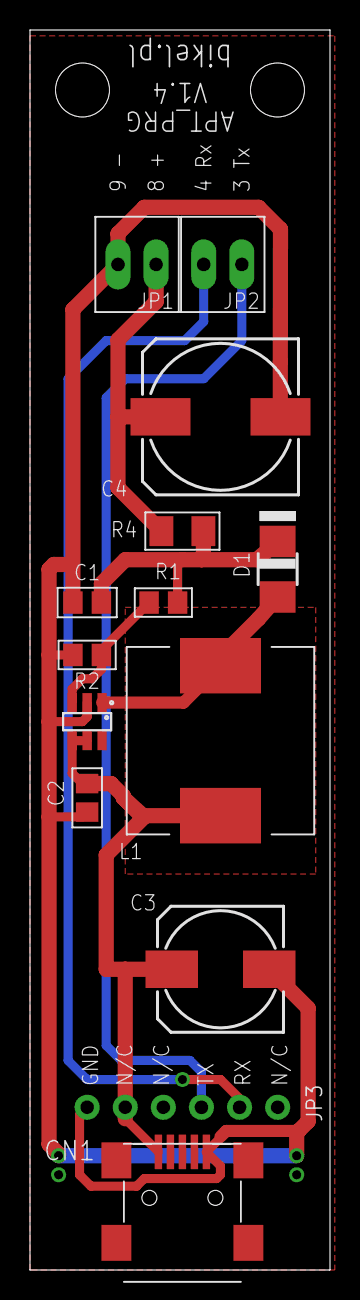
[picture p42: board PRG_APT.brd from above]

Board: 2 copper layers, 20.0 x 82.7 mm, 14 parts (0 on the bottom side), 8 nets.
