BIKEL-PL/MPe_V6_open_source/hardware/current_sensor_boards/WCS1500_PCB/eagle/WCS1500_PCB.brd

## EAGLE design hardware/current_sensor_boards/WCS1500_PCB/eagle/WCS1500_PCB.brd (2025-05-25)

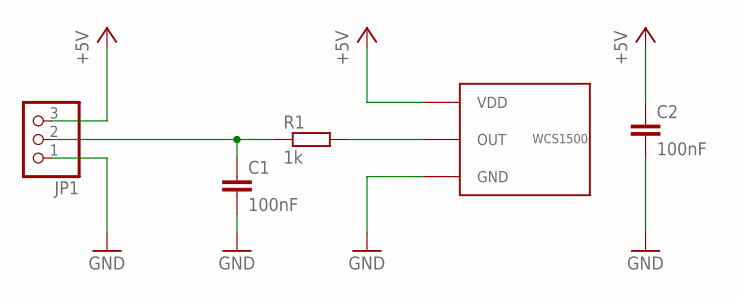
[picture p43: schematic WCS1500_PCB.sch]

Parts:
C1, C2: 100nF; C0603
JP1: PINHD-1X3; 1X03
R1: 1k; R0603
U$1: WCS1500

Connections:
+5V: C2.1, JP1.3, U$1.VDD
GND: C1.2, C2.2, JP1.1, U$1.GND
unnamed: R1.2, U$1.OUT
unnamed: C1.1, JP1.2, R1.1

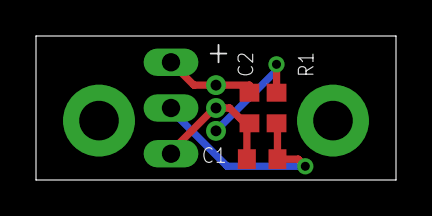
[picture p44: board WCS1500_PCB.brd from above]

Board: 2 copper layers, 20.0 x 8.0 mm, 5 parts (0 on the bottom side), 4 nets.
