BIKEL-PL/MPe_V6_open_source/(notices)

Notices in the files:
firmware/source/MPe-firmware/MPe-oled-display.ino:
MPe-firmware is free software: you can redistribute it and/or modify
it under the terms of the GNU General Public License as published by
the Free Software Foundation, either version 3 of the License, or
(at your option) any later version.
parts and their libraries:
SparkFun-IC-Microcontroller: Licensing: Creative Commons ShareAlike 4.0 International - https://creativecommons.org/licenses/by-sa/4.0
lm1117: (c) 2014 Samuel Lourenço
